Fogotcheck/TracTorKi/README.md

# **[Проект](https://github.com/Fogotcheck/TracTorKi)**

## *Клонирование репозитория*

Клонировать репозиторий вы можете следующим образом:

```console
git clone "git@github.com:Fogotcheck/TracTorKi.git"
```

## *Структура проекта*

```
├── fp-info-cache
├── fp-lib-table
├── lib
│   ├── *.kicad_sym
│   ├── *.dcm
│   ├── *.lib
│   └── *.kicad_mod
├── README.md
├── sch
│   ├── ./../*.kicad_sch
│   ├── ./../...
│   └── ./../*.kicad_sch
├── sym-lib-table
├── TracTorKi.kicad_pcb
├── TracTorKi.kicad_pro
└── TracTorKi.kicad_sch

```

## *Дополнительные ссылки*

* [Трэкер задач](https://github.com/Fogotcheck/TracTorKi/issues/new/choose)
