Fogotcheck/TracTorKi/user_temp/math.md

## Оглавление математической модели TracTorKi

1. Введение и физические параметры шасси
2. Входной вектор управления в открытом контуре
3. Дифференциальная кинематика и дискретное преобразование в ШИМ-сигналы
4. Анализ аномалий ориентации шасси на основе расстояния Махаланобиса
    * 4.1. Математическая модель генерации идеального целевого кватерниона ($q_{target}$)
    * 4.2. Перевод кватерниона ошибки в евклидово касательное пространство алгебры Ли
    * 4.3. Функция динамического масштабирования ковариационной матрицы шумов от ШИМ
    * 4.4. Критерий Хи-квадрат для фиксации аномалий
5. Сенсорная адаптация ToF-дальномеров (VL53L0X)
    * 5.1. Фильтрация Махаланобиса для ToF: Дифференциация пыли и стационарных объектов
    * 5.2. Мультипликативное обновление кватерниона IMU для подавления кубического дрейфа координат
6. Топология и геометрия обхода стационарных препятствий
    * 6.1. Математическая природа автоколебаний при детекции точечных объектов
    * 6.2. Кинематические инварианты: Тангенциальный перенос вектора через кососимметричную матрицу
    * 6.3. Топологический выбор направления обхода
    * 6.4. Финальный микс векторных полей сил
7. Справочная информация
    * 7.1. Таблица критических значений распределения Хи-квадрат ($\chi^2$)
    * 7.2. Геометрическая матрица трансформации координат для перекрёстной топологии датчиков VL53L0X
    * 7.3. Физические константы шасси (масса, база, моменты инерции, центр масс, оптический центр лазерной модели)

## 1. Введение и физические параметры шасси

[ЗАГЛУШКА / TODO: Раздел находится в разработке. Требуется внести финальные инженерные параметры физического прототипа.]

Настоящий раздел предназначен для фиксации базовых массогабаритных и конструктивных характеристик гусеничного шасси TracTorKi. Эти параметры являются фундаментальными константами для работы дифференциальной кинематики, расчета моментов инерции при внешних воздействиях и тригонометрического пересчета векторов дальномеров. 

В финальной версии документа здесь будут зафиксированы:
* Точные геометрические размеры рамы и колесной базы ($B$).
* Масса робота, координаты центра масс относительно геометрического центра.
* Тензор инерции шасси.
* Положение оптических центров лазерных дальномеров VL53L0X относительно связанной системы координат (Body-frame).

## 2. Входной вектор управления в открытом контуре

На самом верхнем уровне абстракции (уровне планирования миссий или дистанционного интерфейса) управление трактором осуществляется дискретными пакетами команд. Каждый пакет представляет собой вектор состояния $\vec{S}$, который жестко регламентирует энергетическое воздействие на движители и временной квант этого воздействия без учета обратной связи от датчиков (открытый контур):

$$\vec{S} = \begin{pmatrix} P_{left} \\ P_{right} \\ T \end{pmatrix}$$

Где компоненты вектора имеют строгое математическое и физическое описание:

*   **$P_{left} \in [-1.0; 1.0]$** — Нормированная безразмерная величина, задающая относительную целевую мощность левого борта гусеничного шасси. Знак определяет направление вращения: $>0$ — вперед, $<0$ — реверс (назад).
*   **$P_{right} \in [-1.0; 1.0]$** — Нормированная безразмерная величина, задающая относительную целевую мощность правого борта гусеничного шасси.
*   **$T \in \mathbb{N}$** — Дискретное время действия команды, выраженное в миллисекундах ($ms$). Определяет временной интервал, в течение которого контроллер обязан удерживать заданные энергетические параметры на моторах, если не зафиксировано аварийных аномалий.

Физический смысл вектора $\vec{S}$ заключается в мгновенном задании кусочно-постоянной функции распределения мощностей в связанной системе координат трактора (Body-frame). Переход к реальному изменению геометрии положения робота в пространстве происходит только после математической проекции данного вектора на уравнения кинематики шасси в следующем разделе.

## 3. Дифференциальная кинематика и дискретное преобразование в ШИМ-сигналы

Этот раздел связывает нормированные значения вектора управления $\vec{S}$ с виртуальными кинематическими параметрами движения шасси и их последующим отображением на физические регистры таймеров микроконтроллера STM32 для управления силовыми драйверами BTS7960.

### 3.1. Уравнения дифференциальной кинематики

Пусть $B$ — ширина колесной базы трактора (расстояние между продольными осями гусениц), а $V_{max}$ — экспериментально определенная максимальная линейная скорость робота при 100% заполнении ШИМ на горизонтальной поверхности. 

Нормированные мощности $P_{left}$ и $P_{right}$ линейно аппроксимируют мгновенные целевые линейные скорости левого ($V_l$) и правого ($V_r$) бортов:
$$V_l = P_{left} \cdot V_{max}$$
$$V_r = P_{right} \cdot V_{max}$$

Виртуальные кинематические параметры движения центра масс трактора в связанной системе координат (Body-frame) рассчитываются по классическим уравнениям плоского движения дифференциального шасси:

1. **Целевая линейная скорость центра масс ($V_{target}$):**
   $$V_{target} = \frac{V_r + V_l}{2} = V_{max} \cdot \frac{P_{right} + P_{left}}{2}$$

2. **Целевая угловая скорость вращения вокруг вертикальной оси Z ($\omega_{target}$):**
   $$\omega_{target} = \frac{V_r - V_l}{B} = \frac{V_{max}}{B} \cdot (P_{right} - P_{left})$$

### 3.2. Дискретное ШИМ-преобразование для драйверов BTS7960

Каждый борт шасси управляется независимым полумостовым драйвером BTS7960, который требует раздельной подачи ШИМ-сигналов на каналы прямого движения (Forward) и реверса (Backward) для исключения сквозных токов.

Пусть $ARR$ (Auto-Reload Register) — максимальное значение периода цифрового таймера STM32, определяющее аппаратную разрядность ШИМ (например, $ARR = 65535$ для 16-битного таймера). 

Математическая функция отображения нормированной мощности $P \in [-1.0; 1.0]$ в дискретные значения регистров сравнения таймера $CCR_{Forward}$ и $CCR_{Backward}$ является кусочно-линейной и имеет вид:

*   **Для левого борта ($P_{left}$):**
    $$CCR_{L\_Forward} = \begin{cases} \lfloor |P_{left}| \cdot ARR \rfloor, & P_{left} \ge 0 \\ 0, & P_{left} < 0 \end{cases}$$
    $$CCR_{L\_Backward} = \begin{cases} 0, & P_{left} \ge 0 \\ \lfloor |P_{left}| \cdot ARR \rfloor, & P_{left} < 0 \end{cases}$$

*   **Для правого борта ($P_{right}$):**
    $$CCR_{R\_Forward} = \begin{cases} \lfloor |P_{right}| \cdot ARR \rfloor, & P_{right} \ge 0 \\ 0, & P_{right} < 0 \end{cases}$$
    $$CCR_{R\_Backward} = \begin{cases} 0, & P_{right} \ge 0 \\ \lfloor |P_{right}| \cdot ARR \rfloor, & P_{right} < 0 \end{cases}$$

Данное преобразование выполняется аппаратно-зависимым слоем абстракции (HAL) микроконтроллера на каждом шаге итерации основного таймера управления.

## 4. Анализ аномалий ориентации шасси на основе расстояния Махаланобиса

### 4.1. Математическая модель генерации идеального целевого кватерниона ($q_{target}$)

Для фиксации внешних механических возмущений (например, воздействие кота или ребенка) бортовой вычислитель должен непрерывно рассчитывать эталонное угловое положение, которое трактор имел бы в идеальных условиях при отсутствии проскальзывания гусениц и внешних сил.

Пусть текущая пространственная ориентация шасси в глобальной системе координат (World-frame) описывается нормированным целевым кватернионом:

$$q_{target}(t) = \begin{pmatrix} w_{tg} \\ x_{tg} \\ y_{tg} \\ z_{tg} \end{pmatrix}, \quad ||q_{target}|| = 1$$

На каждом дискретном такте управления $\Delta t$ (период интеграции одометрии) из кинематических уравнений раздела 3 извлекается вектор целевой угловой скорости движения в связанной системе координат (Body-frame). Так как плоское дифференциальное шасси способно вращаться только вокруг собственной вертикальной оси $Z$, трехмерный вектор угловой скорости $\vec{\omega}_{body}$ имеет вид:

$$\vec{\omega}_{body} = \begin{pmatrix} 0 \\ 0 \\ \omega_{target} \end{pmatrix} = \begin{pmatrix} 0 \\ 0 \\ \frac{V_{max}}{B} \cdot (P_{right} - P_{left}) \end{pmatrix}$$

Изменение ориентации за малый промежуток времени $\Delta t$ описывается кватернионом малого поворота $\Delta q_{tg}$, вычисляемым через экспоненциальное отображение угловой скорости (в приближении малых углов):

$$\Delta q_{tg} \approx \begin{pmatrix} \cos\left(\frac{\omega_{target} \cdot \Delta t}{2}\right) \\ 0 \\ 0 \\ \sin\left(\frac{\omega_{target} \cdot \Delta t}{2}\right) \end{pmatrix}$$

Математическая модель эволюции идеального состояния реализуется путем правого мультипликативного обновления текущего целевого кватерниона на кватернион малого приращения:

$$q_{target}(t + \Delta t) = q_{target}(t) \otimes \Delta q_{tg}$$

Где оператор $\otimes$ выполняет классическое кватернионное умножение Грассмана:

$$q_{target}(t + \Delta t) = \begin{pmatrix} 
w_{tg} \cdot \cos\left(\frac{\omega_{target} \cdot \Delta t}{2}\right) - z_{tg} \cdot \sin\left(\frac{\omega_{target} \cdot \Delta t}{2}\right) \\
x_{tg} \cdot \cos\left(\frac{\omega_{target} \cdot \Delta t}{2}\right) + y_{tg} \cdot \sin\left(\frac{\omega_{target} \cdot \Delta t}{2}\right) \\
y_{tg} \cdot \cos\left(\frac{\omega_{target} \cdot \Delta t}{2}\right) - x_{tg} \cdot \sin\left(\frac{\omega_{target} \cdot \Delta t}{2}\right) \\
z_{tg} \cdot \cos\left(\frac{\omega_{target} \cdot \Delta t}{2}\right) + w_{tg} \cdot \sin\left(\frac{\omega_{target} \cdot \Delta t}{2}\right)
\end{pmatrix}$$

После выполнения операции умножения во избежание накопления вычислительных погрешностей округления микроконтроллер производит принудительную ренормализацию вектора состояния:

$$q_{target} \leftarrow \frac{q_{target}}{||q_{target}||}$$

Полученный кватернион $q_{target}$ выступает в качестве динамического математического эталона для сравнения с физическими показаниями датчика BNO085 на следующем шаге.

### 4.2. Перевод кватерниона ошибки в евклидово касательное пространство алгебры Ли

Для сравнения идеального математического эталона $q_{target}$ с реальным пространственным положением трактора $q_{real}$, транслируемым датчиком BNO085, невозможно использовать классическое евклидово вычитание элементов. Кватернионы лежат на трехмерной гиперсфере $S^3$ в четырехмерном пространстве $\mathbb{R}^4$, и их прямая разность нарушает свойство унитарности ($||q||=1$).

Взаимосвязь между реальной и целевой ориентациями описывается мультипликативным кватернионом ошибки $\Delta q$, который определяет операцию поворота, необходимую для совмещения реального шасси с его идеальной моделью:

$$q_{target} = q_{real} \otimes \Delta q \implies \Delta q = q_{real}^{-1} \otimes q_{target}$$

Операция инверсии для нормированного кватерниона эквивалентна его комплексному сопряжению: $q_{real}^{-1} = \begin{pmatrix} w_{rl} & -x_{rl} & -y_{rl} & -z_{rl} \end{pmatrix}^T$. Результат умножения Грассмана формирует четырехмерный вектор ошибки:

$$\Delta q = \begin{pmatrix} \Delta w \\ \Delta x \\ \Delta y \\ \Delta z \end{pmatrix} = \begin{pmatrix}
w_{rl} \cdot w_{tg} + x_{rl} \cdot x_{tg} + y_{rl} \cdot y_{tg} + z_{rl} \cdot z_{tg} \\
w_{rl} \cdot x_{tg} - x_{rl} \cdot w_{tg} - y_{rl} \cdot z_{tg} + z_{rl} \cdot y_{tg} \\
w_{rl} \cdot y_{tg} + x_{rl} \cdot z_{tg} - y_{rl} \cdot w_{tg} - z_{rl} \cdot x_{tg} \\
w_{rl} \cdot z_{tg} - x_{rl} \cdot y_{tg} + y_{rl} \cdot x_{tg} - z_{rl} \cdot w_{tg}
\end{pmatrix}$$

Для корректного линейного анализа аномалий трехмерный вектор расхождения проецируется из нелинейной группы Ли $SU(2)$ в линейное касательное евклидово пространство алгебры Ли $\mathfrak{so}(3)$ с помощью логарифмического отображения $\operatorname{log}(\Delta q)$. Полученный вектор ошибки $\vec{e}$ выражает физические углы расхождения (в радианах) вокруг трех связанных осей трактора ($X$ — крен, $Y$ — тангаж, $Z$ — рыскание):

$$\vec{e} = \begin{pmatrix} e_x \\ e_y \\ e_z \end{pmatrix} = \operatorname{log}(\Delta q) = \frac{2 \cdot \operatorname{acos}(\Delta w)}{\sqrt{1 - \Delta w^2}} \cdot \begin{pmatrix} \Delta x \\ \Delta y \\ \Delta z \end{pmatrix}$$

Во избежание сингулярности деления на ноль при идеальном совпадении траекторий ($\Delta w \to 1$, $\alpha \to 0$), применяется разложение в ряд Тейлора первого порядка в окрестности нуля. При условии $\sqrt{1 - \Delta w^2} < 10^{-4}$ математический расчет переходит к линейному приближению:

$$\vec{e} \approx 2 \cdot \begin{pmatrix} \Delta x \\ \Delta y \\ \Delta z \end{pmatrix}$$

Вектор $\vec{e}$ представляет собой чистую евклидову метрику расхождения ориентаций, инвариантную к текущему направлению движения робота, и готов к ковариационному анализу.

### 4.3. Функция динамического масштабирования ковариационной матрицы шумов от ШИМ

В процессе движения гусеничное шасси TracTorKi генерирует переменный уровень механических вибраций, зависящий от текущих оборотов двигателей и характера взаимодействия движителей с подстилающей поверхностью. В статической позиции шум измерений инерциального датчика BNO085 минимален, однако при подаче напряжения на моторы дисперсия ошибок угловой ориентации возрастает. 

Чтобы математическая модель не генерировала ложные сигналы об аномалиях при штатном разгоне, ковариационная матрица шумов $\Sigma_t$ должна динамически адаптироваться под текущую нагрузку.

Пусть вектор ошибок $\vec{e} = \begin{pmatrix} e_x & e_y & e_z \end{pmatrix}^T$ распределен по нормальному закону с нулевым математическим ожиданием. Поскольку оси крена ($X$) и тангажа ($Y$) мало подвержены влиянию дифференциального руления, а основная вибрационная нагрузка и проскальзывание приходятся на ось рыскания ($Z$), динамическая ковариационная матрица $\Sigma_t$ имеет диагональный вид:

$$\Sigma_t = \begin{pmatrix} \sigma_{x}^2 & 0 & 0 \\ 0 & \sigma_{y}^2 & 0 \\ 0 & 0 & \sigma_z^2(t) \end{pmatrix}$$

Где компоненты матрицы рассчитываются следующим образом:

1. **Базовый шум осей крена и тангажа:**
   $$\sigma_{x}^2 = \sigma_{static\_x}^2$$
   $$\sigma_{y}^2 = \sigma_{static\_y}^2$$
   *(Значения $\sigma_{static\_x}^2$ и $\sigma_{static\_y}^2$ являются константами, определяемыми в ходе калибровки неподвижного шасси).*

2. **Динамическая дисперсия оси рыскания ($\sigma_z^2(t)$):**
   Функция масштабирования шума зависит от среднего модуля нормированной мощности левого и правого бортов, поступающей из открытого контура (Раздел 2):

   $$\sigma_z^2(t) = \sigma_{static\_z}^2 + K_{vib} \cdot \left( \frac{|P_{left}| + |P_{right}|}{2} \right)^2$$

   Где:
   *   $\sigma_{static\_z}^2$ — дисперсия шума датчика по оси $Z$ в состоянии покоя ($rad^2$).
   *   $K_{vib}$ — безразмерный эмпирический коэффициент структурной вибрации шасси, определяемый экспериментально при движении робота с максимальной мощностью по жесткому грунту.

Благодаря квадратичной зависимости от средней мощности, матрица $\Sigma_t$ мгновенно «раздувает» доверительный интервал в моменты интенсивного ускорения или разворота на месте, повышая устойчивость фильтра к внутренним шумам системы.

### 4.4. Критерий Хи-квадрат для фиксации аномалий

Имея линеаризованный вектор угловых ошибок $\vec{e}$ (Пункт 4.2) и динамическую ковариационную матрицу шумов $\Sigma_t$ (Пункт 4.3), бортовой вычислитель рассчитывает расстояние Махаланобиса $D_M$. Эта метрика определяет многомерное взвешенное расстояние между теоретическим состоянием шасси и реальными показаниями IMU-датчика с учетом переменной интенсивности вибраций:

$$D_M = \sqrt{\vec{e}^T \cdot \Sigma_t^{-1} \cdot \vec{e}}$$

Учитывая диагональную структуру матрицы $\Sigma_t$, операция обращения матрицы $\Sigma_t^{-1}$ сводится к вычислению обратных величин её диагональных элементов. Это позволяет упростить квадратичную форму до эффективного скалярного уравнения:

$$D_M = \sqrt{\frac{e_x^2}{\sigma_{x}^2} + \frac{e_y^2}{\sigma_{y}^2} + \frac{e_z^2}{\sigma_z^2(t)}}$$

Математически квадрат расстояния Махаланобиса $D_M^2$ для трехмерного вектора ошибок ($k = 3$ степеней свободы) подчиняется распределению Хи-квадрат ($\chi^2$). Для фиксации аномалий применяется статистический критерий согласия Пирсона с заданным уровнем значимости $\alpha = 0.01$ (вероятность ложноположительного срабатывания менее 1%):

$$D_M^2 > \chi^2_{1-\alpha}(3)$$

Согласно таблице критических значений распределения Хи-квадрат для 3 степеней свободы (Раздел 7.1), пороговое значение составляет $\chi^2_{0.99}(3) = 11.345$, что эквивалентно линейному порогу расстояния Махаланобиса $D_{thresh} \approx 3.368$. 

Логика принятия решений классифицирует состояние системы по следующим математическим интервалам:
*   **$D_M \le 2.21$** — Номинальный режим: расхождение вызвано естественным белым шумом датчика, система стабильна.
*   **$2.21 < D_M \le 3.37$** — Пограничный режим: повышенный уровень скольжения гусениц или движение по сильно пересеченной местности, система корректирует траекторию в штатном режиме.
*   **$D_M > 3.37$** — **Внешняя механическая аномалия**: гипотеза о соответствии реального движения математической модели отвергается. Контроллер фиксирует факт стороннего физического сдвига шасси (толчок ребенком, воздействие кота), прерывает таймер открытого контура $T$ и переходит к процедуре экстренной релокализации.

## 5. Сенсорная адаптация ToF-дальномеров (VL53L0X)

### 5.1. Фильтрация Махаланобиса для ToF: Буферизация и дифференциация стационарных объектов

Лазерные дальномеры ToF (Time-of-Flight) подвержены кратковременным оптическим шумам, фазовому дрожанию (jitter) и резким помехам (пыль, шерсть). Прямое вычисление скорости изменения дистанции по двум последовательным отсчётам приводит к катастрофическому усилению высокочастотного шума. Для корректного принятия решений модель использует накопление измерений в скользящем временном окне (буфере) фиксированной длительности $\tau \approx 200\text{--}500$ мс.

Для каждого лазерного дальномера $i \in \{1, 2, 3, 4\}$ бортовой вычислитель поддерживает кольцевой буфер из $N$ последних отсчётов, полученных с постоянным периодом дискретизации $\Delta t$:

$$\mathcal{B}_i = \{D_i(t), D_i(t-\Delta t), D_i(t-2\Delta t), \dots, D_i(t-(N-1)\Delta t)\}$$

На основе накопленного буфера $\mathcal{B}_i$ вектор состояния ToF-луча $\vec{x}_{tof, i}$ формируется не через мгновенные разности, а через робастную оценку тренда методом линейной регрессии (наименьших квадратов) внутри временного окна:

$$\vec{x}_{tof, i} = \begin{pmatrix} \bar{D}_i(t) \\ \dot{D}_{i, \text{est}}(t) \end{pmatrix}$$

Где:
*   $\bar{D}_i(t)$ — усредненное (сглаженное) текущее расстояние, вычисленное по буферу.
*   $\dot{D}_{i, \text{est}}(t)$ — наклонение линии тренда (оценка скорости изменения дистанции), минимизирующее среднеквадратичное отклонение в буфере:

$$\dot{D}_{i, \text{est}}(t) = \frac{N \sum_{k=0}^{N-1} (t_k \cdot D_i(t_k)) - \sum_{k=0}^{N-1} t_k \sum_{k=0}^{N-1} D_i(t_k)}{N \sum_{k=0}^{N-1} t_k^2 - \left(\sum_{k=0}^{N-1} t_k\right)^2}$$

Математическое ожидание (прогноз) вектора измерений строится на базе предыдущего стабильного состояния и физической скорости трактора $V_{target}$ из Раздела 3, спроецированной на ось $i$-го луча с углом наклона $\gamma_i$:

$$\vec{\mu}_{tof, i} = \begin{pmatrix} \bar{D}_i(t-\Delta t) - V_{target} \cdot \cos(\gamma_i) \cdot \Delta t \\ -V_{target} \cdot \cos(\gamma_i) \end{pmatrix}$$

Ковариационная матрица $\Sigma_{tof}$ в данном случае рассчитывается динамически на основе выборочной дисперсии шума внутри самого накопленного буфера $\mathcal{B}_i$, что позволяет учитывать текущую оптическую стабильность среды (например, запыленность):

$$\Sigma_{tof} = \begin{pmatrix} \sigma^2_{buf, i} & 0 \\ 0 & \frac{\sigma^2_{buf, i}}{\tau} \end{pmatrix}$$

Где $\sigma^2_{buf, i}$ — несмещенная дисперсия расстояния по $N$ элементам буфера.

Расчет расстояния Махаланобиса выполняется по сглаженным метрикам:

$$D_{M\_tof, i} = \sqrt{(\vec{x}_{tof, i} - \vec{\mu}_{tof, i})^T \cdot \Sigma_{tof}^{-1} \cdot (\vec{x}_{tof, i} - \vec{\mu}_{tof, i})}$$

Статистический критерий Хи-квадрат для 2 степеней свободы ($\chi^2_{0.99}(2) = 9.21$) делит входящий поток данных на два класса:
1.  **$D_{M\_tof, i} \le 3.03$ (Стационарный объект):** Линейный тренд буфера полностью совпадает с кинематикой трактора. Препятствие признается неподвижным и стабильным ориентиром окружения (стена, шкаф, крупная мебель). Данные $\bar{D}_i(t)$ признаются валидными и передаются в алгоритм мультипликативной коррекции кватерниона IMU (Пункт 5.2) для сброса дрейфа.
2.  **$D_{M\_tof, i} > 3.03$ (Аномалия измерения):** Вектор тренда и дисперсия буфера не соответствуют предсказанной кинематике движения шасси. Объект классифицируется как динамическая или оптическая помеха (пролетевшая пыль, прыгнувший кот, взмах руки, занос гусеницы). 
    *   **Действие системы:** Модель временно **запрещает** использовать данный ToF-луч для корректировки навигационного контура IMU во избежание внесения ложных смещений. Трактор продолжает штатное выполнение текущего полетного задания открытого контура, временно накапливая внутреннюю ошибку инерциальной одометрии до момента стабилизации показаний дальномера. Никаких команд принудительного торможения или изменения ШИМ-сигналов на моторы в данном подпункте не генерируется.

### 5.2. Мультипликативное обновление кватерниона IMU для подавления кубического дрейфа координат

Инерциальная система навигации на базе датчика BNO085 обладает высокой дискретностью, но подвержена накоплению систематических погрешностей. Ошибки интегрирования угловых скоростей вызывают линейный дрейф углов ориентации, а двойное интегрирование линейных ускорений приводит к кубическому росту ошибки определения координат по времени ($t^3$). 

Чтобы разорвать эту зависимость, математическая модель использует верифицированные стационарные измерения дальномеров VL53L0X ($D_{M\_tof, i} \le 3.03$) для фильтрации и периодической коррекции вектора состояния.

Пусть $q_{pred}$ — текущий кватернион ориентации, предсказанный инерциальной системой, а $D_{real, i} = \bar{D}_i(t)$ — чистое расстояние от $i$-го датчика, прошедшее фильтр Махаланобиса. Известная геометрическая конфигурация лучей (Раздел 7.2) позволяет рассчитать ожидаемое расстояние до стационарного ориентира $D_{pred, i}$. 

Математический шаг обновления (Correction) строится на принципах мультипликативного фильтра Калмана (MEKF):

1. **Вычисление скалярной инновации (невязки измерения):**
   $$y_i = D_{real, i} - D_{pred, i}$$

2. **Расчет вектора поправки в касательном пространстве:**
   Через оптимальный коэффициент обратной связи $K_i$ (вес Калмана, определяемый соотношением дисперсий предсказания IMU и измерения ToF) инновация отображается в трехмерный вектор малых угловых ошибок $\vec{\delta\theta}$:
   $$\vec{\delta\theta} = \begin{pmatrix} \delta\theta_x \\ \delta\theta_y \\ \delta\theta_z \end{pmatrix} = K_i \cdot y_i \cdot \vec{u}_i$$
   Где $\vec{u}_i$ — единичный вектор направления $i$-го лазерного луча в связанной системе координат трактора.

3. **Формирование корректирующего кватерниона малого поворота ($\delta q$):**
   Вектор малой ошибки преобразуется обратно в пространство кватернионов через ортогональную проекцию на гиперсферу:
   $$\delta q \approx \begin{pmatrix} 1 \\ \frac{\delta\theta_x}{2} \\ \frac{\delta\theta_y}{2} \\ \frac{\delta\theta_z}{2} \end{pmatrix}$$

4. **Мультипликативный пересчет матрицы ориентации:**
   Коррекция вносится путем правого кватернионного умножения Грассмана, что исключает появление линейных сингулярностей, характерных для углов Эйлера:
   $$q_{corrected} = q_{pred} \otimes \delta q$$

5. **Ренормализация и сброс дрейфа одометрии:**
   После внесения поправки вектор состояния принудительно возвращается на единичную гиперсферу, а накопленная кубическая ошибка скорости по оси скорректированного луча обнуляется:
   $$q_{corrected} \leftarrow \frac{q_{corrected}}{||q_{corrected}||}$$

Этот шаг математически «привязывает» координатную сетку трактора к стационарным физическим объектам среды, полностью останавливая временной дрейф интеграторов IMU по тем осям, которые перекрываются геометрией датчиков.

## 6. Топология и геометрия обхода стационарных препятствий

### 6.1. Математическая природа автоколебаний при детекции точечных объектов

Тонкие вертикальные препятствия, такие как ножки стульев, столов или малогабаритные игрушки, математически интерпретируются дальномерами как точечные объекты (цилиндры исчезающе малого радиуса $r \to 0$). Специфика лазерных ToF-датчиков VL53L0X заключается в чрезвычайно узкой диаграмме направленности излучения (конус излучения FoV составляет порядка $25^\circ$, а центральное пятно измерения еще уже). Из-за этой особенности возникает фундаментальная топологическая ловушка при попытке реализации классического пропорционального отталкивания.

Рассмотрим систему, в которой вектор силы отталкивания $\vec{F}_{rep}$ направлен строго коллинеарно лучу датчика — от обнаруженной точечной аномалии к геометрическому центру трактора. Физико-математический механизм возникновения незатухающих автоколебаний (релаксационного осцилляционного процесса) протекает по следующим фазам:

1. **Фаза детекции и отклонения:** Трактор движется вперед; один из перекрестных лучей (например, лучи №3 или №4 согласно схеме из Раздела 7.2) пересекает ножку стула на критической дистанции $D_{real} < R_{safe}$. Махаланобис валидирует стационарность объекта. Модель генерирует вектор отталкивания $\vec{F}_{rep}$, модуль которого обратно пропорционален расстоянию. Под действием этой силы трактор начинает динамически разворачивать шасси в противоположную от объекта сторону.

2. **Фаза срыва слежения:** Как только угловое смещение трактора превышает половину угла FoV датчика, точечный объект мгновенно «выпадает» из узкого лазерного луча. В эту же миллисекунду расстояние до объекта прыгает до бесконечности (или до дальней стены), и вектор силы отталкивания мгновенно обнуляется:
   $$\vec{F}_{rep} \to \vec{0}$$

3. **Фаза возврата и столкновения:** Поскольку целевой вектор открытого контура $\vec{F}_{att}$ (Раздел 2) продолжает требовать движения вперед к исходной цели, трактор прекращает маневр уклонения и начинает выравнивать курс обратно. Траектория робота снова пересекается с координатой ножки стула.

4. **Замыкание цикла:** Луч дальномера повторно натыкается на точечное препятствие, вызывая резкий скачок силы $\vec{F}_{rep}$. 

Математически данный процесс описывается нелинейным дифференциальным уравнением второго порядка с релейной функцией обратной связи и запаздыванием. На фазовой плоскости траектория системы замыкается в устойчивый предельный цикл (Limit Cycle). В физическом мире это выражается в том, что трактор начинает циклически «дёргаться» и совершать высокочастотные колебания (эффект рыскания) непосредственно перед ножкой стула, теряя линейную скорость и в конечном итоге совершая механическое столкновение с препятствием из-за инерции шасси.

### 6.2. Кинематические инварианты: Тангенциальный перенос вектора через кососимметричную матрицу

Чтобы полностью исключить разрыв обратной связи и разрушить предельный цикл автоколебаний, математическая модель переводит трактор из режима фронтального отталкивания в режим орбитального огибания. Для этого вокруг обнаруженной точечной координаты аномалии $(X_{obs}, Y_{obs})$ в связанной системе координат (Body-frame) искусственно выстраивается инвариантная круговая граница — сфера безопасности радиуса $R_{safe}$.

Математический маневр уклонения требует, чтобы результирующий вектор движения был направлен не в сторону от объекта, а строго по касательной к окружности радиуса $R_{safe}$. Преобразование радиальной силы в тангенциальную траекторию реализуется через аппарат линейной алгебры с применением двумерной кососимметричной матрицы поворота.

Пусть $\vec{F}_{rep} = \begin{pmatrix} F_{rep\_x} & F_{rep\_y} \end{pmatrix}^T$ — исходный вектор радиального выталкивания, направленный от точечного препятствия к центру масс трактора. Мы осуществляем ортогональное проецирование этого вектора в касательное пространство путем умножения на кососимметричную матрицу оператора поворота на угол $\pm\pi/2$:

$$\vec{F}_{tangent} = \mathbf{J} \cdot \vec{F}_{rep}$$

Где матрица поворота $\mathbf{J}$ имеет вид:

$$\mathbf{J} = \begin{pmatrix} 0 & -\Lambda \\ \Lambda & 0 \end{pmatrix}$$

Параметр $\Lambda \in \{-1; 1\}$ является топологическим инвариантом знака и жестко определяет бинарный выбор направления обхода препятствия:
*   $\Lambda = 1$ — Поворот вектора на $+90^\circ$ (математически против часовой стрелки).
*   $\Lambda = -1$ — Поворот вектора на $-90^\circ$ (математически по часовой стрелке).

Разворачивая матричное уравнение в систему скалярных кинематических инвариантов, получаем точные компоненты тангенциального вектора переноса:

$$F_{tangent\_x} = -\Lambda \cdot F_{rep\_y}$$
$$F_{tangent\_y} = \Lambda \cdot F_{rep\_x}$$

Полученный вектор $\vec{F}_{tangent}$ обладает свойством строгой ортогональности к радиальному вектору ($\vec{F}_{tangent} \cdot \vec{F}_{rep} = 0$). Физический смысл этой операции заключается в том, что вместо хаотичного отворачивания назад, модель генерирует постоянную виртуальную «орбитальную скорость». Трактор начинает двигаться по гладкой дуге вокруг ножки стула, удерживая её под постоянным фиксированным углом к лучам лазерных дальномеров (VL53L0X). Это гарантирует непрерывность слежения за препятствием и полностью подавляет любые триггерные осцилляции.

### 6.3. Топологический выбор направления обхода

Для однозначного раскрытия неопределенности знака инварианта $\Lambda \in \{-1; 1\}$ в подразделе 6.2 бортовой вычислитель должен в реальном времени решать топологическую задачу оптимизации маршрута. Выбор направления огибания (слева или справа) основывается на минимизации энергетических затрат и интегрального отклонения от исходного курса открытого контура.

#### 6.3.1. Скалярный критерий знака для одиночного препятствия
Пусть $\vec{F}_{att} = \begin{pmatrix} F_{att\_x} & F_{att\_y} \end{pmatrix}^T$ — притягивающий вектор глобальной цели, а $\vec{F}_{tangent}(\Lambda)$ — тангенциальный вектор обхода, зависящий от знака $\Lambda$. Математическим критерием оптимальности является максимизация скалярного произведения этих векторов, что соответствует минимизации угла расхождения между направлением обхода и направлением на цель:

$$\Lambda^* = \arg\max_{\Lambda \in \{-1, 1\}} \left( \vec{F}_{tangent}(\Lambda) \cdot \vec{F}_{att} \right)$$

Разворачивая скалярное произведение через компоненты векторов, получаем явную аналитическую функцию знака (signum), не требующую тригонометрических вычислений на процессоре STM32:

$$\Lambda^* = \operatorname{sgn} \left( F_{rep\_x} \cdot F_{att\_y} - F_{rep\_y} \cdot F_{att\_x} \right)$$

Если результирующее выражение строго больше нуля, присваивается $\Lambda = 1$ (обход слева), если меньше — $\Lambda = -1$ (обход справа). В редком случае строгого равенства нулю (коллинеарный лобовой упор) знак выбирается аппаратно на основе приоритета датчиков схемы из Раздела 7.2 (например, в сторону датчика с наименьшим текущим значением шума).

#### 6.3.2. Суперпозиция полей при множественных целях (Проблема «Узких ворот»)
Когда в зону безопасности $R_{safe}$ одновременно попадают несколько стационарных аномалий (например, две смежные ножки стула или стола), система строит аддитивное топологическое поле. Для $M$ одновременно обнаруженных объектов суммарный вектор отталкивания и результирующий знак обхода рассчитываются через весовую суперпозицию:

$$\vec{F}_{rep\_sum} = \sum_{j=1}^{M} w_j \cdot \vec{F}_{rep, j}$$

Где вес $w_j = \left(\frac{1}{D_j} - \frac{1}{R_{safe}}\right)$ увеличивает приоритет наиболее близких к шасси препятствий. 

В ситуации, когда два объекта находятся по разные стороны от продольной оси трактора (слева и справа), их радиальные силы взаимно компенсируют друг друга в проекции на ось $Y$, смещая суммарный вектор $\vec{F}_{rep\_sum}$ строго на ось $X$ (торможение). Топологический инвариант знака $\Lambda^*$ для объединенного поля автоматически рассчитывается через результирующий вектор:

$$\Lambda^* = \operatorname{sgn} \left( F_{rep\_sum\_x} \cdot F_{att\_y} - F_{rep\_sum\_y} \cdot F_{att\_x} \right)$$

Если расстояние между двумя ножками меньше физической ширины базы шасси $B$, модули векторов отталкивания резко возрастают, полностью блокируя продвижение вперед по оси $X$ через механизмы Пункта 6.4. Система топологически распознает тупик («узкие ворота»), принудительно разворачивает вектор $\vec{F}_{att}$ в обратную сторону и инициирует маневр безопасного отката по касательной дуге до момента раскрытия створа препятствий.

### 6.4. Финальный микс векторных полей сил

На заключительном этапе навигационного цикла бортовой вычислитель выполняет суперпозицию всех сформированных векторных полей для вычисления результирующего вектора управления $\vec{F}_{result}$. Этот вектор осуществляет плавную подмену исходных жестких команд открытого контура, обеспечивая безопасное огибание препятствий без разрыва траектории.

Математическое сложение трех независимых полей сил в связанной системе координат (Body-frame) имеет вид:

$$\vec{F}_{result} = \vec{F}_{att} + \vec{F}_{rep\_sum} + \vec{F}_{tangent}$$

Где физическая роль каждого слагаемого строго регламентирована:
1.  **$\vec{F}_{att}$** — Сила глобального притяжения к цели, сонаправленная с исходным вектором управления $\vec{S}$. Она удерживает трактор на основном маршруте.
2.  **$\vec{F}_{rep\_sum}$** — Суммарная радиальная сила выталкивания (Пункт 6.3.2). Она гарантирует физическое непересечение установленной сферы безопасности $R_{safe}$.
3.  **$\vec{F}_{tangent}$** — Тангенциальная сила обхода (Пункт 6.2). Она задает орбитальный перенос вдоль границы препятствия.

Из полученного вектора $\vec{F}_{result} = \begin{pmatrix} F_{res\_x} & F_{res\_y} \end{pmatrix}^T$ извлекается скорректированный целевой угол направления движения $\alpha_{res}$ относительно продольной оси трактора:

$$\alpha_{res} = \operatorname{atan2}(F_{res\_y}, F_{res\_x})$$

Финальный пересчет нормированных мощностей для левого ($P_{left\_new}$) и правого ($P_{right\_new}$) бортов гусеничного шасси выполняется по закону пропорционального регулирования угла курса:

$$P_{left\_new} = F_{res\_x} - K_p \cdot \alpha_{res}$$
$$P_{right\_new} = F_{res\_x} + K_p \cdot \alpha_{res}$$

Где $K_p$ — коэффициент жесткости руления, определяющий динамику закручивания шасси в маневр. Для предотвращения аппаратного насыщения ШИМ-таймеров полученные значения мощностей проходят операцию жесткого ограничения (насыщения) в исходный рабочий диапазон Раздела 2:

$$P_{left\_new} \leftarrow \max(-1.0, \min(1.0, P_{left\_new}))$$
$$P_{right\_new} \leftarrow \max(-1.0, \min(1.0, P_{right\_new}))$$

Скорректированные нормированные мощности $P_{left\_new}$ и $P_{right\_new}$ напрямую передаются на слой преобразования в ШИМ-сигналы (Раздел 3), замыкая контур автоматического адаптивного управления платформой.

## 7. Справочная информация и аналитические инварианты

### 7.1. Таблица критических значений распределения Хи-квадрат ($\chi^2$)
Для детекции аномалий ориентации шасси (Раздел 4.4) и валидации ToF-измерений дальномеров (Раздел 5.1) в памяти микроконтроллера STM32 фиксируются константные пороговые значения распределения Хи-квадрат ($\chi^2$). Ниже представлена таблица критических значений $\chi^2_{1-\alpha}(k)$ в зависимости от числа степеней свободы $k$ и заданного уровня значимости $\alpha$:

| Число степеней свободы ($k$) | $\alpha = 0.10$ (10%) | $\alpha = 0.05$ (5%) | $\alpha = 0.01$ (1%) | Применение в системе TracTorKi |
| :--- | :--- | :--- | :--- | :--- |
| **1** | 2.706 | 3.841 | 6.635 | Одномерные скалярные фильтры |
| **2** | 4.605 | 5.991 | **9.210** | Валидация ToF-лучей (дистанция и скорость) |
| **3** | 6.251 | 7.815 | **11.345**| Анализ аномалий кватерниона IMU (3 оси алгебры Ли) |

Математический переход от порогового квадрата расстояния Махаланобиса $D_M^2 > \chi^2_{1-\alpha}(k)$ к линейному порогу $D_{thresh}$ осуществляется через извлечение квадратного корня:
*   Для ToF-датчиков ($k=2$, $\alpha=0.01$): $D_{thresh} = \sqrt{9.210} \approx 3.035$
*   Для кватерниона IMU ($k=3$, $\alpha=0.01$): $D_{thresh} = \sqrt{11.345} \approx 3.368$

### 7.2. Динамическая идентификация центра масс на основе инерциальной фильтрации (IMU-based CoG Estimation)

Для исключения погрешностей априорного взвешивания компонентов, модель производит динамическую оценку вектора положения центра масс $\vec{r}_{cg}$ непосредственно на основе кинематических корреляций датчика BNO085 в процессе калибровочного маневра.

Пусть связанная система координат (Body-frame) жестко привязана к точке оптического/геометрического центра инерциального датчика IMU. Вектор смещения реального центра масс шасси относительно датчика обозначается как $\vec{r}_{c} = \begin{pmatrix} X_c & Y_c & Z_c \end{pmatrix}^T$. 

Связь между измеряемым акселерометром ускорением в точке крепления $\vec{a}_{imu}$ и истинным ускорением центра масс $\vec{a}_{cg}$ описывается кинематическим уравнением твердого тела:

$$\vec{a}_{imu} = \vec{a}_{cg} + \vec{\varepsilon} \times \vec{r}_{c} + \vec{\omega} \times (\vec{\omega} \times \vec{r}_{c})$$

При выполнении тестового вращения шасси на месте (разворот в открытом контуре с противоположными знаками мощностей $P_{left} = -P_{right}$), истинное линейное ускорение центра масс стремится к нулю ($\vec{a}_{cg} \to \vec{0}$). Проекция уравнений на плоскость движения $XY$ формирует систему для идентификации горизонтального смещения:

$$a_x(t) = \varepsilon_z(t) \cdot Y_c - \omega_z^2(t) \cdot X_c$$
$$a_y(t) = -\varepsilon_z(t) \cdot X_c - \omega_z^2(t) \cdot Y_c$$

Где $a_x, a_y, \omega_z$ — прямые высокодискретные измерения датчика BNO085, а $\varepsilon_z = \frac{\Delta \omega_z}{\Delta t}$ — вычисляемое угловое ускорение. Бортовой вычислитель STM32 методом наименьших квадратов (МНК) по накопленному буферу калибровочного маневра разрешает данную систему относительно инвариантов геометрии:

$$\begin{pmatrix} X_c \\ Y_c \end{pmatrix} = \left( \mathbf{A}^T \mathbf{A} \right)^{-1} \mathbf{A}^T \vec{\mathbf{Y}}$$

Где матрица измерений $\mathbf{A}$ и вектор ограничений $\vec{\mathbf{Y}}$ строятся динамически на скользящем окне калибровки. Вертикальная координата высоты центра масс $Z_c$ оценивается во второй фазе теста при линейном ускорении по оси $X$ через величину динамического завала угла тангажа (Pitch), регистрируемого кватернионом IMU под действием сил опрокидывания. Динамически вычисленный вектор $\vec{r}_{c}$ используется для мгновенной корректировки плеча сил инерции в критериях аварийной остановки платформы (Раздел 7.4).

### 7.3. Геометрия перекрёстной топологии и аналитическая модель автоматической калибровки оптических углов датчиков VL53L0X

Вместо использования априорных чертежных значений углов установки, система реализует алгоритм автоматической геометрической самокалибровки ToF-лучей (Auto-Calibration via Planar Target) при совершении тестовых перемещений относительно плоской стационарной поверхности (стены).

Пусть связанная система координат (Body-frame) привязана к динамическому центру масс шасси (Раздел 7.2). Каждый датчик $i \in \{1, 2, 3, 4\}$ характеризуется точкой пространственного размещения своего оптического центра $\vec{r}_{sns, i} = \begin{pmatrix} x_i & y_i \end{pmatrix}^T$ и вектором направления луча $\vec{u}_i = \begin{pmatrix} \cos(\gamma_i) & \sin(\gamma_i) \end{pmatrix}^T$.

#### 7.3.1. Аналитическая идентификация углов лучей ($\gamma_i$)
При совершении калибровочного маневра (линейное перемещение строго вдоль продольной оси $X$ на величину $\Delta X$, верифицированную энкодерами и базовыми фронтальными датчиками №1 и №2), изменение показаний дистанции $\Delta D_i$ каждого ToF-сенсора жестко инвариантно к углу его пространственного наклона:

$$\Delta D_i = \Delta X \cdot \cos(\gamma_i)$$

Бортовой вычислитель накапливает массив измерений $\mathcal{M}_i = \{ \Delta X_k, \Delta D_{i,k} \}$ во временном окне калибровки и вычисляет истинные углы оптических осей лучей через тригонометрическое отображение:

$$\gamma_i = \operatorname{sgn}(\gamma_{i, \text{prior}}) \cdot \operatorname{acos}\left( \frac{\sum_{k=1}^{K} \Delta X_k \cdot \Delta D_{i,k}}{\sum_{k=1}^{K} \Delta X_k^2} \right)$$

Где $\operatorname{sgn}(\gamma_{i, \text{prior}})$ — бинарный знак базового полупространства установки датчика согласно конструктивной схеме (отрицательный для правого сектора луча №3, положительный для левого сектора луча №4).

#### 7.3.2. Матричное преобразование ToF-дистанции в декартовы координаты
После успешного завершения фазы самокалибровки и фиксации углов $\gamma_i$, матричный пересчет текущей скалярной ToF-дистанции $D_i$ в декартовы координаты препятствия $\vec{P}_{obs, i}$ в связанной системе координат трактора приобретает адаптивный вид:

$$\vec{P}_{obs, i} = \begin{pmatrix} X_{obs, i} \\ Y_{obs, i} \end{pmatrix} = \begin{pmatrix} x_i + D_i \cdot \cos(\gamma_i) \\ y_i + D_i \cdot \sin(\gamma_i) \end{pmatrix}$$

#### 7.3.3. Зависимость углов перекрестных лучей №3 и №4 на геометрию безопасной зоны маневра
Перекрестные лучи №3 и №4 пересекаются в пространстве перед передним бампером трактора. Точка их геометрического пересечения $\vec{P}_{intersect} = \begin{pmatrix} X_{int} & Y_{int} \end{pmatrix}^T$ является вершиной треугольника зоны гарантированной триангуляции центральных объектов. 

Аналитическое выражение координат точки пересечения лучей из уравнений прямых линий:

$$X_{int} = \frac{y_4 - y_3 + x_3 \tan(\gamma_3) - x_4 \tan(\gamma_4)}{\tan(\gamma_3) - \tan(\gamma_4)}$$
$$Y_{int} = y_3 + (X_{int} - x_3) \cdot \tan(\gamma_3)$$

Вычисленные в процессе самокалибровки углы $\gamma_3$ и $\gamma_4$ динамически проверяются на обеспечение **минимального продольного размера безопасной зоны маневра** ($L_{safe}$). Чтобы трактор успевал отработать тангенциальный обход ножки стула (Раздел 6.2), точка пересечения лучей должна лежать строго дальше радиуса сферы безопасности от переднего габарита шасси $X_{front}$:

$$X_{int} - X_{front} \ge R_{safe}$$

Если в процессе калибровки выявляется, что тригонометрическое условие нарушено (например, датчик сместился физически или угол обзора слишком узкий), система автоматически масштабирует (уменьшает) радиус сферы безопасности $R_{safe}$ и линейную базовую скорость $V_{target}$ в алгоритмах обхода (Раздел 6.4) для сохранения динамической устойчивости платформы.

### 7.4. Критерии полной остановки и блокировки платформы

В отличие от штатного изменения векторов мощностей в процессе обхода препятствий (Раздел 6.4), модель накладывает три жестких логических критерия аварийной ситуации, требующих немедленной полной остановки трактора ($P_{left\_new} = 0$, $P_{right\_new} = 0$) и сброса ШИМ-таймеров в ноль:

1. **Критерий критического сближения (Геометрический упор):**
   Если любой из четырех ToF-датчиков фиксирует сглаженную валидную дистанцию меньше абсолютного физического предела остановки $D_{stop}$:
   $$\exists i \in \{1, 2, 3, 4\} : \bar{D}_i(t) \le D_{stop}$$
   *(Параметр $D_{stop}$ рассчитывается динамически как сумма тормозного пути шасси на текущей скорости и конструктивного вылета бампера относительно оптических центров лазеров).*

2. **Критерий топологического запирания (Проблема «Узких ворот»):**
   При одновременной фиксации препятствий слева и справа, когда аналитический расчет декартовых координат полей (Пункт 6.3.2) показывает, что ширина свободного створа $W_{aperture}$ между препятствиями меньше ширины трактора с учетом динамического зазора безопасности $\Delta B$:
   $$W_{aperture} = ||\vec{P}_{obs, j} - \vec{P}_{obs, k}|| < B + \Delta B$$
   В данном состоянии алгоритм обхода не может сформировать знак инварианта $\Lambda^*$, система блокирует движение для предотвращения заклинивания робота между объектами.

3. **Критерий потери пространственной локализации (IMU Fault):**
   Если расстояние Махаланобиса для вектора ошибок ориентации (Раздел 4.4) пробивает критический верхний порог достоверности в течение длительного времени $\Delta T_{fault} \approx 500$ мс:
   $$\int_{t-\Delta T_{fault}}^{t} [D_M(\tau) > 5.0] \, d\tau = \Delta T_{fault}$$
   Это состояние сигнализирует о полном перевороте шасси, критическом застревании гусеничного привода или непрекращающемся внешнем удержании робота руками. Модель принудительно гасит моторы для предотвращения сгорания силовых ключей BTS7960 от токов короткого замыкания.
