Fogotcheck/TracTorKi/production/TracTorKi.csv

Reference | Qty | Value | DNP | Exclude from BOM | Exclude from Board | Footprint | Datasheet | Type | Voltage | type | voltage | Описание
C1,C30,C31 | 3 | 1µF |  |  |  | Capacitor_SMD:C_1206_3216Metric_Pad1.33x1.80mm_HandSolder |  |  |  |  | X7R, 50V | Unpolarized capacitor
C2,C3,C4,C32,C33,C34,C35,C36,C41,C50,C61 | 11 | 1µF |  |  |  | Capacitor_SMD:C_0603_1608Metric_Pad1.08x0.95mm_HandSolder |  |  |  |  |  | Unpolarized capacitor
C5 | 1 | 100nF |  |  |  | Capacitor_SMD:C_1206_3216Metric_Pad1.33x1.80mm_HandSolder |  |  |  |  | X7R, 50V | Unpolarized capacitor
C6 | 1 | 4.7 µF |  |  |  | Capacitor_SMD:C_1206_3216Metric_Pad1.33x1.80mm_HandSolder |  |  |  |  | X7R, 50V | Unpolarized capacitor
C7 | 1 | 47 nF |  |  |  | Capacitor_SMD:C_1206_3216Metric_Pad1.33x1.80mm_HandSolder |  |  |  |  | X7R, 50V
C8,C9,C10,C11,C13,C14,C15,C19,C22,C25,C26,C27,C40,C48,C57 | 15 | 10µF |  |  |  | Capacitor_SMD:C_1206_3216Metric_Pad1.33x1.80mm_HandSolder |  |  |  |  | 50V,X7R, 50V | Unpolarized capacitor
C12,C21,C23,C24 | 4 | 0.1µF |  |  |  | Capacitor_SMD:C_1206_3216Metric_Pad1.33x1.80mm_HandSolder |  |  |  |  | X7R, 50V | Unpolarized capacitor
C16 | 1 | 1nF |  |  |  | Capacitor_SMD:C_1206_3216Metric_Pad1.33x1.80mm_HandSolder |  |  | 50V |  |  | Unpolarized capacitor
C17,C18 | 2 | 47 nF |  |  |  | Capacitor_SMD:C_0603_1608Metric_Pad1.08x0.95mm_HandSolder |  |  |  |  | X7R, 50V
C20 | 1 | 2.2µF |  |  |  | Capacitor_SMD:C_1206_3216Metric_Pad1.33x1.80mm_HandSolder |  |  |  |  | X7R, 50V
C28,C29,C56 | 3 | 33µF |  |  |  | Capacitor_Tantalum_SMD:CP_EIA-7343-31_Kemet-D_HandSolder |  |  |  |  | 50V | Polarized capacitor
C37,C38,C44,C45,C46,C47,C52,C53,C54,C55,C63,C64,C65,C66 | 14 | 22µF |  |  |  | Capacitor_SMD:C_0603_1608Metric_Pad1.08x0.95mm_HandSolder |  |  |  |  |  | X5R
C39,C43,C51,C62,C67,C68,C69,C135,C136 | 9 | 0.1µF |  |  |  | Capacitor_SMD:C_0603_1608Metric_Pad1.08x0.95mm_HandSolder |  |  |  |  |  | Unpolarized capacitor
C42,C49,C58 | 3 | 220nF |  |  |  | Capacitor_SMD:C_1206_3216Metric_Pad1.33x1.80mm_HandSolder |  |  |  |  | 50V
C70,C71 | 2 | 8.2pF |  |  |  | Capacitor_SMD:C_0603_1608Metric_Pad1.08x0.95mm_HandSolder |  |  |  |  |  | Unpolarized capacitor
C72,C73,C74,C75,C76,C132 | 6 | 100nF |  |  |  | Capacitor_SMD:C_0603_1608Metric_Pad1.08x0.95mm_HandSolder |  |  |  |  |  | Unpolarized capacitor
C77,C78 | 2 | 10pF |  |  |  | Capacitor_SMD:C_0402_1005Metric_Pad0.74x0.62mm_HandSolder |  |  |  |  |  | Unpolarized capacitor
C79,C82,C83,C84,C86,C87,C88,C90,C91,C92,C93,C94,C95,C96,C99,C101,C106,C111,C112,C114,C115,C117,C118,C120,C121,C123,C124,C125,C126,C128 | 30 | 100nF |  |  |  | Capacitor_SMD:C_0402_1005Metric_Pad0.74x0.62mm_HandSolder |  |  |  |  |  | Unpolarized capacitor
C80 | 1 | 470pF |  |  |  | Capacitor_SMD:C_0402_1005Metric_Pad0.74x0.62mm_HandSolder |  |  |  |  |  | Unpolarized capacitor
C81 | 1 | 1uF |  |  |  | Capacitor_SMD:C_0402_1005Metric_Pad0.74x0.62mm_HandSolder |  |  |  |  |  | Unpolarized capacitor
C85 | 1 | 10uF |  |  |  | Capacitor_SMD:C_0603_1608Metric_Pad1.08x0.95mm_HandSolder |  |  |  |  |  | Unpolarized capacitor
C89 | 1 | 1000pF |  |  |  | Capacitor_SMD:C_1812_4532Metric_Pad1.57x3.40mm_HandSolder |  |  |  |  | 2000V | Unpolarized capacitor
C97,C100 | 2 | 10µF |  |  |  | Capacitor_Tantalum_SMD:CP_EIA-3216-18_Kemet-A_HandSolder |  |  |  |  |  | Polarized capacitor
C102,C103,C104,C105 | 4 | 470nF |  |  |  | Capacitor_SMD:C_0402_1005Metric_Pad0.74x0.62mm_HandSolder |  |  |  |  |  | Unpolarized capacitor
C107,C108 | 2 | 2.2uF |  |  |  | Capacitor_SMD:C_0603_1608Metric_Pad1.08x0.95mm_HandSolder |  |  |  | X5R |  | Unpolarized capacitor
C109,C110 | 2 | 1uF |  |  |  | Capacitor_SMD:C_0603_1608Metric_Pad1.08x0.95mm_HandSolder |  |  |  | X5R |  | Unpolarized capacitor
C113,C116,C119,C122 | 4 | 4.7uF |  |  |  | Capacitor_Tantalum_SMD:CP_EIA-3216-18_Kemet-A_HandSolder |  |  |  |  |  | Polarized capacitor
C129 | 1 | 1uF |  |  |  | Capacitor_Tantalum_SMD:CP_EIA-2012-12_Kemet-R_HandSolder |  |  |  |  |  | Polarized capacitor
C130,C131 | 2 | 6.8pF |  |  |  | Capacitor_SMD:C_0603_1608Metric_Pad1.08x0.95mm_HandSolder |  |  |  |  |  | Unpolarized capacitor
C133,C134 | 2 | 1.5pF |  |  |  | Capacitor_SMD:C_0603_1608Metric_Pad1.08x0.95mm_HandSolder |  |  |  | C0G |  | Unpolarized capacitor
D1 | 1 | ESDA25W |  |  |  | Package_TO_SOT_SMD:SOT-323_SC-70 | https://static.chipdip.ru/lib/197/DOC017197250.pdf |  |  |  |  | TVS Diode Array, 5.5V Standoff, 2 Channels, SOT23
D2 | 1 | ESDA25P35-1U1M |  |  |  | TracTorKi:ESDA25P35-1U1M_QFN-2L_1.6x1.0mm | https://static.chipdip.ru/lib/314/DOC018314341.pdf |  |  |  |  | TVS diode
D3 | 1 | BAT54W |  |  |  | Package_TO_SOT_SMD:SOT-323_SC-70 | https://assets.nexperia.com/documents/data-sheet/BAT54W_SER.pdf |  |  |  |  | Schottky barrier diode, SOT-323
D4 | 1 | ESDALC6V1-W2 |  |  |  | Package_TO_SOT_SMD:SOT-323_SC-70 | https://www.st.com/resource/en/datasheet/esdalc6v1w2.pdf |  |  |  |  | Schottky barrier diode, SOT-323
D5 | 1 | LTSTC19HE1WT |  |  |  | LED_SMD:LED_LiteOn_LTST-C19HE1WT | https://static.chipdip.ru/lib/077/DOC034077889.pdf |  |  |  |  | RGB LED, blue/green/red/anode
FB1 | 1 | 600R@100MHz |  |  |  | Inductor_SMD:L_0805_2012Metric_Pad1.05x1.20mm_HandSolder |  |  |  |  |  | Ferrite bead
FB2 | 1 | FBMJ1608HM180NTR |  |  |  | Inductor_SMD:L_0603_1608Metric_Pad1.05x0.95mm_HandSolder |  |  |  |  |  | Ferrite bead
J1 | 1 | USB_C_Receptacle_USB2.0_14P |  |  |  | Connector_USB:USB_C_Receptacle_GCT_USB4085 | https://gct.co/files/drawings/usb4085.pdf |  |  |  |  | USB 2.0-only 14P Type-C Receptacle connector
J2 | 1 | Conn_01x03_Pin |  |  |  | Connector_Molex:Molex_Micro-Latch_53254-0370_1x03_P2.00mm_Horizontal |  |  |  |  |  | Generic connector, single row, 01x03, script generated
J3 | 1 | Conn_01x03_Pin |  |  |  | Connector_PinHeader_2.54mm:PinHeader_1x03_P2.54mm_Vertical |  |  |  |  |  | Generic connector, single row, 01x03, script generated
J4 | 1 | RJ45_Amphenol_RJMG1BD3B8K1ANR |  |  |  | Connector_RJ:RJ45_Amphenol_RJMG1BD3B8K1ANR | https://www.amphenol-cs.com/media/wysiwyg/files/drawing/rjmg1bd3b8k1anr.pdf |  |  |  |  | 1 Port RJ45 Magjack Connector Through Hole 10/100 Base-T, AutoMDIX
J5 | 1 | Micro_SD_Card_Det1 |  |  |  | Connector_Card:microSD_HC_Hirose_DM3AT-SF-PEJM5 | https://datasheet.lcsc.com/lcsc/2110151630_XKB-Connectivity-XKTF-015-N_C381082.pdf |  |  |  |  | Micro SD Card Socket with one card detection pin
J6,J7 | 2 | Molex 502386-0970 |  |  |  | Connector_Molex:Molex_CLIK-Mate_502386-0970_1x09-1MP_P1.25mm_Horizontal | https://www.molex.com/en-us/products/part-detail/5023860970 |  |  |  |  | Molex CLIK-Mate 1.25 mm, 9 circuits, single-row horizontal SMT receptacle
J8,J9 | 2 | Conn_01x02_Pin |  |  |  | Connector_Molex:Molex_Micro-Fit_3.0_43650-0200_1x02_P3.00mm_Horizontal |  |  |  |  |  | Generic connector, single row, 01x02, script generated
J10,J11,J12,J13 | 4 | Conn_01x06_Pin |  |  |  | Connector_Molex:Molex_MicroClasp_55935-0610_1x06_P2.00mm_Horizontal |  |  |  |  |  | Generic connector, single row, 01x06, script generated
J14 | 1 | Conn_ARM_JTAG_SWD_10 |  |  |  | Connector_PinHeader_1.27mm:PinHeader_2x05_P1.27mm_Vertical | http://infocenter.arm.com/help/topic/com.arm.doc.ddi0314h/DDI0314H_coresight_components_trm.pdf |  |  |  |  | Cortex Debug Connector, standard ARM Cortex-M SWD and JTAG interface
J15 | 1 | Conn_01x05_Pin |  |  |  | Connector_Molex:Molex_Micro-Fit_3.0_43650-0500_1x05_P3.00mm_Horizontal |  |  |  |  |  | Generic connector, single row, 01x05, script generated
L1 | 1 | 2.2 µH |  |  |  | Inductor_SMD:L_Chilisin_BMRx00060630 | https://static.chipdip.ru/lib/633/DOC043633403.pdf |  |  |  |  | BMRA000606302R2MA1
L2 | 1 | 8.2µH |  |  |  | Inductor_SMD:L_Chilisin_BMRx00060630 | https://static.chipdip.ru/lib/633/DOC043633403.pdf |  |  |  |  | BMRF000606308R2MA1
L3 | 1 | 15µH |  |  |  | Inductor_SMD:L_Chilisin_BMRx00060630 | https://static.chipdip.ru/lib/633/DOC043633403.pdf |  |  |  |  | BMRA00060630150MA1
L4 | 1 | 6.8µH |  |  |  | Inductor_SMD:L_Chilisin_BMRx00060630 | https://static.chipdip.ru/lib/633/DOC043633403.pdf |  |  |  |  | BMRA000606306R8MA1
Q1,Q2 | 2 | IRFTS9342PBF |  |  |  | Package_SO:TSOP-6_1.65x3.05mm_P0.95mm | https://www.infineon.com/dgdl/irfts9342pbf.pdf?fileId=5546d462533600a40153563aeabc21f3 |  |  |  |  | -5.8A Id, -30V Vds, 40mOhm Rds, P-Channel HEXFET Power MOSFET, TSOP-6
Q3,Q4,Q5 | 3 | CSD17577Q3A |  |  |  | Package_SON:VSON-8_3.3x3.3mm_P0.65mm_NexFET | https://www.ti.com/lit/ds/symlink/csd17577q3a.pdf |  |  |  |  | 35A Id, 30V Vds, NexFET N-Channel Power MOSFET, 4.0mOhm Ron, Qg Typ 12nC, VSON-8 3.3x3.3mm
R1,R16 | 2 | 470 |  |  |  | Resistor_SMD:R_1206_3216Metric_Pad1.30x1.75mm_HandSolder |  |  |  |  |  | Resistor
R2,R6 | 2 | 1K |  |  |  | Resistor_SMD:R_1206_3216Metric_Pad1.30x1.75mm_HandSolder |  |  |  |  |  | Resistor
R3,R5,R7,R8,R9,R34,R36,R39 | 8 | 100K |  |  |  | Resistor_SMD:R_0603_1608Metric_Pad0.98x0.95mm_HandSolder |  |  |  |  |  | Resistor
R4 | 1 | 22K |  |  |  | Resistor_SMD:R_0603_1608Metric_Pad0.98x0.95mm_HandSolder |  |  |  |  |  | Resistor
R10 | 1 | 150K |  |  |  | Resistor_SMD:R_0603_1608Metric_Pad0.98x0.95mm_HandSolder |  |  |  |  |  | Resistor
R11 | 1 | 27K |  |  |  | Resistor_SMD:R_0603_1608Metric_Pad0.98x0.95mm_HandSolder |  |  |  |  |  | Resistor
R12 | 1 | 30.31K |  |  |  | Resistor_SMD:R_0603_1608Metric_Pad0.98x0.95mm_HandSolder |  |  |  |  |  | Resistor
R13 | 1 | 5.24K |  |  |  | Resistor_SMD:R_0603_1608Metric_Pad0.98x0.95mm_HandSolder |  |  |  |  |  | Resistor
R14 | 1 | 100 |  |  |  | Resistor_SMD:R_1206_3216Metric_Pad1.30x1.75mm_HandSolder |  |  |  |  |  | Resistor
R15 | 1 | 2 |  |  |  | Resistor_SMD:R_1206_3216Metric_Pad1.30x1.75mm_HandSolder |  |  |  |  |  | Resistor
R17,R18,R19,R20,R21,R25 | 6 | 1K |  |  |  | Resistor_SMD:R_0603_1608Metric_Pad0.98x0.95mm_HandSolder |  |  |  |  |  | Resistor
R22 | 1 | 1mΩ |  |  |  | Resistor_SMD:R_2512_6332Metric_Pad1.40x3.35mm_HandSolder |  |  |  |  |  | Resistor
R23 | 1 | 4.5K |  |  |  | Resistor_SMD:R_0603_1608Metric_Pad0.98x0.95mm_HandSolder |  |  |  |  |  | Resistor
R24,R26 | 2 | 1M |  |  |  | Resistor_SMD:R_0603_1608Metric_Pad0.98x0.95mm_HandSolder |  |  |  |  |  | Resistor
R27 | 1 | 470K |  |  |  | Resistor_SMD:R_0603_1608Metric_Pad0.98x0.95mm_HandSolder |  |  |  |  |  | Resistor
R28,R30,R47,R48,R49,R50,R51,R52,R53,R54,R58,R61,R62,R63,R71,R73,R74,R75,R77,R78,R79,R80,R81,R82,R83,R84,R85,R86,R87,R88,R89,R90,R115,R116,R117,R118,R129,R131 | 38 | 10K |  |  |  | Resistor_SMD:R_0603_1608Metric_Pad0.98x0.95mm_HandSolder |  |  |  |  |  | Resistor
R29 | 1 | 604K |  |  |  | Resistor_SMD:R_0603_1608Metric_Pad0.98x0.95mm_HandSolder |  |  |  |  |  | Resistor
R31 | 1 | 10K |  |  |  | Resistor_SMD:R_1206_3216Metric_Pad1.30x1.75mm_HandSolder |  |  |  |  |  | Resistor
R32 | 1 | 3.57 |  |  |  | Resistor_SMD:R_0603_1608Metric_Pad0.98x0.95mm_HandSolder |  |  |  |  |  | Resistor
R33 | 1 | 1.15 |  |  |  | Resistor_SMD:R_0603_1608Metric_Pad0.98x0.95mm_HandSolder |  |  |  |  |  | Resistor
R35 | 1 | 24.9K |  |  |  | Resistor_SMD:R_0603_1608Metric_Pad0.98x0.95mm_HandSolder |  |  |  |  |  | Resistor
R37 | 1 | 9.09K |  |  |  | Resistor_SMD:R_0603_1608Metric_Pad0.98x0.95mm_HandSolder |  |  |  |  |  | Resistor
R38,R41 | 2 | 20K |  |  |  | Resistor_SMD:R_0603_1608Metric_Pad0.98x0.95mm_HandSolder |  |  |  |  |  | Resistor
R40,R184,R185 | 3 | 330 |  |  |  | Resistor_SMD:R_0603_1608Metric_Pad0.98x0.95mm_HandSolder |  |  |  |  |  | Resistor
R42 | 1 | 38.3K |  |  |  | Resistor_SMD:R_0603_1608Metric_Pad0.98x0.95mm_HandSolder |  |  |  |  |  | Resistor
R43,R44,R91,R92,R93,R94,R95,R96,R97,R98 | 10 | 100 |  |  |  | Resistor_SMD:R_0603_1608Metric_Pad0.98x0.95mm_HandSolder |  |  |  |  |  | Resistor
R45,R46,R111,R112,R113,R114,R119,R120,R121,R122,R123,R124,R125,R126,R127,R128,R175,R176,R177,R178,R179,R180,R181,R182,R183 | 25 | 4.7K |  |  |  | Resistor_SMD:R_0603_1608Metric_Pad0.98x0.95mm_HandSolder |  |  |  |  |  | Resistor
R55,R56,R57,R60,R132,R133,R134,R135,R136,R137,R138,R139,R140,R141,R142,R143,R144,R145,R146,R147,R148,R149,R150,R151,R152,R153,R154,R155,R156,R157,R158,R159,R160,R161,R162,R163,R164,R165,R166,R167,R168,R169,R170,R171,R172,R173 | 46 | 33 |  |  |  | Resistor_SMD:R_0402_1005Metric_Pad0.72x0.64mm_HandSolder |  |  |  |  |  | Resistor
R59 | 1 | 1.5K |  |  |  | Resistor_SMD:R_0603_1608Metric_Pad0.98x0.95mm_HandSolder |  |  |  |  |  | Resistor
R64 | 1 | 12.1K |  |  |  | Resistor_SMD:R_0603_1608Metric_Pad0.98x0.95mm_HandSolder |  |  |  |  |  | Resistor
R65,R66,R67,R68 | 4 | 49.9 |  |  |  | Resistor_SMD:R_0603_1608Metric_Pad0.98x0.95mm_HandSolder |  |  |  |  |  | Resistor
R69,R70 | 2 | 270 |  |  |  | Resistor_SMD:R_0603_1608Metric_Pad0.98x0.95mm_HandSolder |  |  |  |  |  | Resistor
R72 | 1 | 1M |  |  |  | Resistor_SMD:R_1206_3216Metric_Pad1.30x1.75mm_HandSolder |  |  |  |  |  | Resistor
R99,R102,R105,R106 | 4 | 1K |  |  |  | Resistor_SMD:R_0402_1005Metric_Pad0.72x0.64mm_HandSolder |  |  |  |  |  | Resistor
R100,R103,R107,R109 | 4 | 15K |  |  |  | Resistor_SMD:R_0402_1005Metric_Pad0.72x0.64mm_HandSolder |  |  |  |  |  | Resistor
R101,R104,R108,R110 | 4 | 1.2K |  |  |  | Resistor_SMD:R_0402_1005Metric_Pad0.72x0.64mm_HandSolder |  |  |  |  |  | Resistor
R130 | 1 | 10K |  |  |  | Resistor_SMD:R_0805_2012Metric_Pad1.20x1.40mm_HandSolder |  |  |  |  |  | Resistor
R174 | 1 | 0 |  |  |  | Resistor_SMD:R_0402_1005Metric_Pad0.72x0.64mm_HandSolder |  |  |  |  |  | Resistor
SW1 | 1 | CK_KMS2xxG |  |  |  | Button_Switch_SMD:SW_SPST_CK_KMS2xxGP | https://www.ckswitches.com/media/1482/kms.pdf |  |  |  |  | Microminiature SMT Side Actuated, 4.2 x 2.8 x 1.42mm, without pegs, with shield pin
U1 | 1 | BQ25798RQMR |  |  |  | Package_DFN_QFN:Texas_RQM0029A_VQFN-29_4x4mm_P0.4mm | https://www.ti.com/lit/ds/symlink/bq25798.pdf |  |  |  |  | I2C controlled, 5A Buck-Boost battery charger (1-4 cell, Li-Ion / Li-Polymer), USB BC1.2 / HVDCP detection, 3.6..24V VBUS, 3..18.8V charge voltage regulation, 0.75..1.5 MHz, VQFN-29 (Texas RQM0029A)
U2 | 1 | STUSB4500QTR |  |  |  | Package_DFN_QFN:QFN-24-1EP_4x4mm_P0.5mm_EP2.7x2.7mm | https://www.st.com/resource/en/datasheet/stusb4500.pdf |  |  |  |  | Stand-alone USB PD controller (with sink Auto-run mode), QFN-24
U3 | 1 | BQ7791500PWR |  |  |  | Package_SO:TSSOP-24_4.4x7.8mm_P0.65mm | https://static.chipdip.ru/lib/079/DOC043079178.pdf
U4,U5,U6 | 3 | LMR33630ADDA |  |  |  | Package_SO:Texas_HSOP-8-1EP_3.9x4.9mm_P1.27mm_ThermalVias | http://www.ti.com/lit/ds/symlink/lmr33630.pdf |  |  |  |  | Simple Switcher Synchronous Buck Regulator, Vin=3.8-36V, Iout=3A, F=400kHz, Adjustable output voltage, HSOP-8
U7 | 1 | TPS7A9201DSKR |  |  |  | Package_DFN_QFN:Texas_S-PDSO-N10_EP1.2x2mm | https://www.ti.com/lit/ds/symlink/tps7a92.pdf |  |  |  |  | Texas Instruments TPS7A92 Low Noise Low Dropout Voltage Regulator device is a low-noise (4.8µV RMS ), low-dropout (LDO) voltage regulator capable of sourcing 2A with only 180mV of dropout. The TPS7A92 output is adjustable with external resistors from 0.8V to 5.2V. The TPS7A92 wide input-voltage range supports operation as low as 1.4V and up to 6.5V. With 1% output voltage accuracy (over the line, load, and temperature) and soft-start capabilities to reduce inrush current, the TPS7A92 is ideal for powering sensitive analog low-voltage devices. These types of devices include voltage-controlled oscillators (VCOs), analog-to-digital converters (ADCs), digital-to-analog converters (DACs), high-end processors, and field-programmable gate arrays (FPGAs). The TPS7A92 is designed to power noise-sensitive components such as those found in high-speed communication, video, medical, or test, and measurement applications.
U8 | 1 | IP4252CZ12 |  |  |  | Package_SON:Nexperia_HUSON-12_USON-12-1EP_1.35x2.5mm_P0.4mm_EP0.4x2mm | https://assets.nexperia.com/documents/data-sheet/IP4251_52_53_54-TTL.pdf |  |  |  |  | 6 channel EMI filters with integrated ESD protection, 12 pF, 40 Ohm
U9 | 1 | LAN8742A-CZ-TR |  |  |  | Package_DFN_QFN:VQFN-24-1EP_4x4mm_P0.5mm_EP2.5x2.5mm_ThermalVias | http://ww1.microchip.com/downloads/en/DeviceDoc/8742a.pdf |  |  |  |  | LAN8720 Ethernet PHY with RMII interface, QFN-24
U10 | 1 | BME280 |  |  |  | Package_LGA:Bosch_LGA-8_2.5x2.5mm_P0.65mm_ClockwisePinNumbering | https://www.bosch-sensortec.com/media/boschsensortec/downloads/datasheets/bst-bme280-ds002.pdf |  |  |  |  | 3-in-1 sensor, humidity, pressure, temperature, I2C and SPI interface, 1.71-3.6V, LGA-8
U11 | 1 | BNO085 |  |  |  | Package_LGA:LGA-28_5.2x3.8mm_P0.5mm | https://static.chipdip.ru/lib/063/DOC057063187.pdf |  |  |  |  | Intelligent 9-axis absolute orientation sensor, LGA-28
U12 | 1 | USBLC6-4SC6 |  |  |  | Package_TO_SOT_SMD:SOT-23-6 | https://www.st.com/resource/en/datasheet/usblc6-4.pdf |  |  |  |  | Very low capacitance ESD protection diode, 4 data-line, SOT-23-6
U13 | 1 | IS42S16160J-7TLI |  |  |  | Package_SO:TSOP-II-54_22.2x10.16mm_P0.8mm | http://www.issi.com/WW/pdf/42-45S16400J.pdf |  |  |  |  | 64Mb Synchronous DRAM, 1 Mb x 16 b x 4 Banks, Alloy42 leadframe plated with matte Sn, TSOP-II-54
U15 | 1 | 74HCT245D |  |  |  | Package_SO:SOIC-20W_7.5x12.8mm_P1.27mm | https://static.chipdip.ru/lib/567/DOC059567337.pdf |  |  |  |  | Octal BUS Transceivers, 3-State outputs
U16 | 1 | TLV9004xRUCR |  |  |  | Package_DFN_QFN:Texas_S-PX2QFN-14 | http://www.ti.com/lit/ds/symlink/tlv9004.pdf |  |  |  |  | Low-Power, Quad-Operational Amplifiers, Texas S-PX2QFN-14
U17 | 1 | PCA9516APW |  |  |  | Package_SO:TSSOP-16_4.4x5mm_P0.65mm | http://www.nxp.com/docs/en/data-sheet/PCA9518.pdf |  |  |  |  | 5 channels I2C Hub, SO/TSSOP16
U18 | 1 | STM32H743ZIT6 |  |  |  | ST_stm32H743zit6:LQFP144-20x20mm | https://www.st.com/resource/en/datasheet/stm32h743vi.pdf | Type |  |  |  | High-performance and DSP with DP-FPU, Arm Cortex-M7 MCU with 2MBytes of Flash memory, 1MB RAM, 480 MHz CPU, Art Accelerator, L1 cache, external memory interface, large set of peripherals
U19 | 1 | TCA9517ADGK |  |  |  | Package_SO:VSSOP-8_3x3mm_P0.65mm | https://www.ti.com/lit/ds/symlink/tca9517a.pdf |  |  |  |  | Level-Translating I2C Bus Buffer/Repeater, VSSOP-8
Y1,Y4 | 2 | NX3215SA-32.768KHZ-EXS00A-MU00525 |  |  |  | Crystal:Crystal_SMD_3215-2Pin_3.2x1.5mm | https://static.chipdip.ru/lib/014/DOC004014433.pdf |  |  |  |  | STD-MUA-14,Two pin crystal
Y2 | 1 | NX3225HA-25MHz-EXS00A-CH00343 |  |  |  | Crystal:Crystal_SMD_3225-4Pin_3.2x2.5mm_HandSoldering |  |  |  |  |  | Four pin crystal, GND on pins 2 and 4
Y3 | 1 | NX2016SA 25MHz |  |  |  | Crystal:Crystal_SMD_2016-4Pin_2.0x1.6mm | https://static.chipdip.ru/lib/174/DOC042174554.pdf |  |  |  |  | NX2016SA-25MHZ-STD-CZS-2
