Fogotcheck/TracTorKi/TracTorKi.kicad_pcb

## KiCad design TracTorKi.kicad_pcb (2026-11-12)

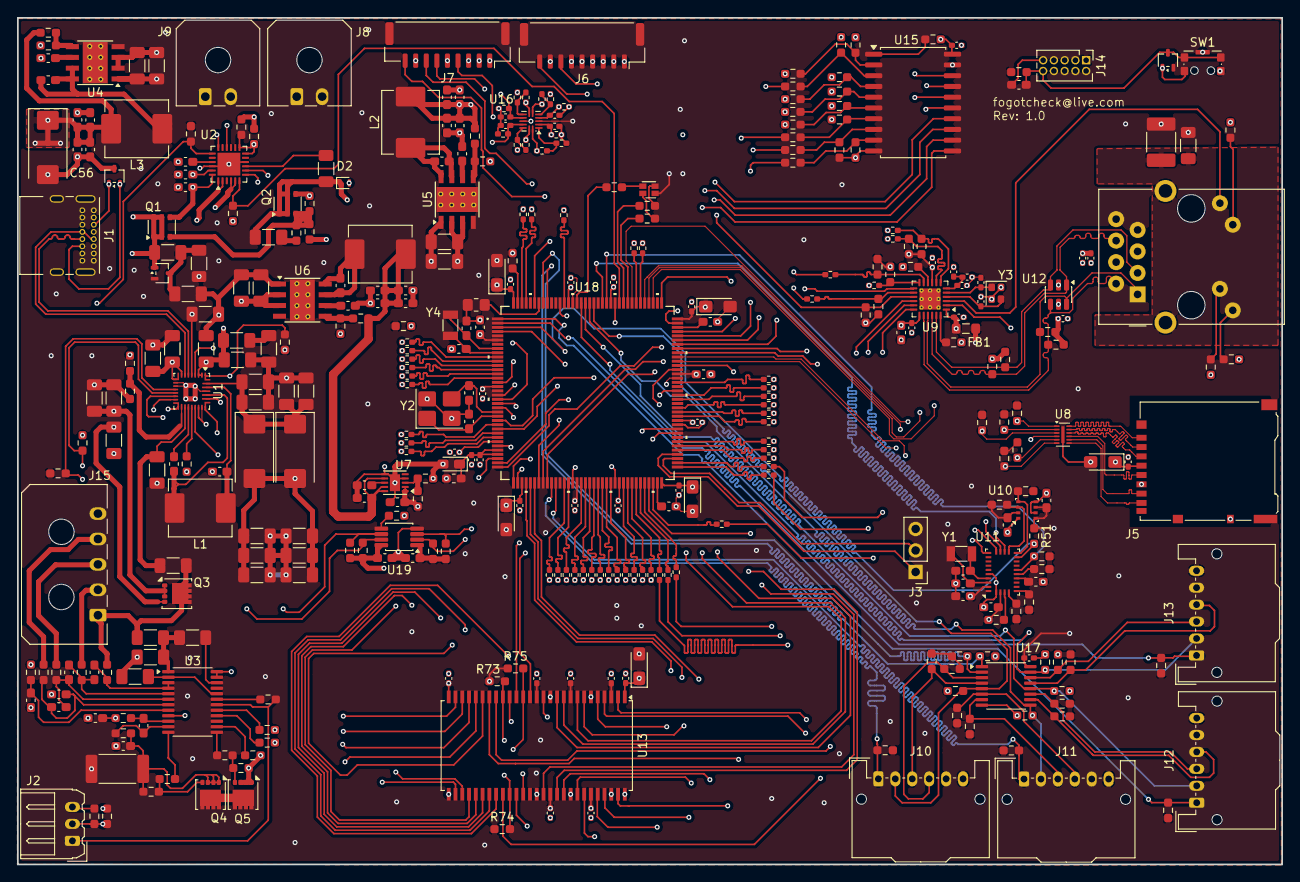
[picture p1: board TracTorKi.kicad_pcb from above]

Board: 6 copper layers, 149.4 x 100.0 mm, 370 parts (0 on the bottom side), 295 nets.

Parts:
C1, C30, C31: 1µF; C_1206_3216Metric_Pad1.33x1.80mm_HandSolder
C2, C3, C4, C32, C33, C34, C35, C36, C41, C50, C61: 1µF; C_0603_1608Metric_Pad1.08x0.95mm_HandSolder
C5: 100nF; C_1206_3216Metric_Pad1.33x1.80mm_HandSolder
C6: 4.7 µF; C_1206_3216Metric_Pad1.33x1.80mm_HandSolder
C7: 47 nF; C_1206_3216Metric_Pad1.33x1.80mm_HandSolder
C8, C9, C10, C11, C13, C14, C15, C19, C22, C25, C26, C27, C40, C48, C57: 10µF; C_1206_3216Metric_Pad1.33x1.80mm_HandSolder
C12, C21, C23, C24: 0.1µF; C_1206_3216Metric_Pad1.33x1.80mm_HandSolder
C16: 1nF; C_1206_3216Metric_Pad1.33x1.80mm_HandSolder
C17, C18: 47 nF; C_0603_1608Metric_Pad1.08x0.95mm_HandSolder
C20: 2.2µF; C_1206_3216Metric_Pad1.33x1.80mm_HandSolder
C28, C29, C56: 33µF; CP_EIA-7343-31_Kemet-D_HandSolder
C37, C38, C44, C45, C46, C47, C52, C53, C54, C55, C63, C64, C65, C66: 22µF; C_0603_1608Metric_Pad1.08x0.95mm_HandSolder
C39, C43, C51, C62, C67, C68, C69, C135, C136: 0.1µF; C_0603_1608Metric_Pad1.08x0.95mm_HandSolder
C42, C49, C58: 220nF; C_1206_3216Metric_Pad1.33x1.80mm_HandSolder
C70, C71: 8.2pF; C_0603_1608Metric_Pad1.08x0.95mm_HandSolder
C72, C73, C74, C75, C76, C132: 100nF; C_0603_1608Metric_Pad1.08x0.95mm_HandSolder
C77, C78: 10pF; C_0402_1005Metric_Pad0.74x0.62mm_HandSolder
C79, C82, C83, C84, C86, C87, C88, C90, C91, C92, C93, C94, C95, C96, C99, C101, C106, C111, C112, C114, C115, C117, C118, C120, C121, C123, C124, C125, C126, C128: 100nF; C_0402_1005Metric_Pad0.74x0.62mm_HandSolder
C80: 470pF; C_0402_1005Metric_Pad0.74x0.62mm_HandSolder
C81: 1uF; C_0402_1005Metric_Pad0.74x0.62mm_HandSolder
C85: 10uF; C_0603_1608Metric_Pad1.08x0.95mm_HandSolder
C89: 1000pF; C_1812_4532Metric_Pad1.57x3.40mm_HandSolder
C97, C100: 10µF; CP_EIA-3216-18_Kemet-A_HandSolder
C102, C103, C104, C105: 470nF; C_0402_1005Metric_Pad0.74x0.62mm_HandSolder
C107, C108: 2.2uF; C_0603_1608Metric_Pad1.08x0.95mm_HandSolder
C109, C110: 1uF; C_0603_1608Metric_Pad1.08x0.95mm_HandSolder
C113, C116, C119, C122: 4.7uF; CP_EIA-3216-18_Kemet-A_HandSolder
C129: 1uF; CP_EIA-2012-12_Kemet-R_HandSolder
C130, C131: 6.8pF; C_0603_1608Metric_Pad1.08x0.95mm_HandSolder
C133, C134: 1.5pF; C_0603_1608Metric_Pad1.08x0.95mm_HandSolder
D1: ESDA25W; SOT-323_SC-70
D2: ESDA25P35-1U1M; ESDA25P35-1U1M_QFN-2L_1.6x1.0mm
D3: BAT54W; SOT-323_SC-70
D4: ESDALC6V1-W2; SOT-323_SC-70
D5: LTSTC19HE1WT; LED_LiteOn_LTST-C19HE1WT
FB1: 600R@100MHz; L_0805_2012Metric_Pad1.05x1.20mm_HandSolder
FB2: FBMJ1608HM180NTR; L_0603_1608Metric_Pad1.05x0.95mm_HandSolder
J1: USB_C_Receptacle_USB2.0_14P; USB_C_Receptacle_GCT_USB4085
J2: Conn_01x03_Pin; Molex_Micro-Latch_53254-0370_1x03_P2.00mm_Horizontal
J3: Conn_01x03_Pin; PinHeader_1x03_P2.54mm_Vertical
J4: RJ45_Amphenol_RJMG1BD3B8K1ANR
J5: Micro_SD_Card_Det1; microSD_HC_Hirose_DM3AT-SF-PEJM5
J6, J7: Molex 502386-0970; Molex_CLIK-Mate_502386-0970_1x09-1MP_P1.25mm_Horizontal
J8, J9: Conn_01x02_Pin; Molex_Micro-Fit_3.0_43650-0200_1x02_P3.00mm_Horizontal
J10, J11, J12, J13: Conn_01x06_Pin; Molex_MicroClasp_55935-0610_1x06_P2.00mm_Horizontal
J14: Conn_ARM_JTAG_SWD_10; PinHeader_2x05_P1.27mm_Vertical
J15: Conn_01x05_Pin; Molex_Micro-Fit_3.0_43650-0500_1x05_P3.00mm_Horizontal
L1: 2.2 µH; L_Chilisin_BMRx00060630
L2: 8.2µH; L_Chilisin_BMRx00060630
L3: 15µH; L_Chilisin_BMRx00060630
L4: 6.8µH; L_Chilisin_BMRx00060630
Q1, Q2: IRFTS9342PBF; TSOP-6_1.65x3.05mm_P0.95mm
Q3, Q4, Q5: CSD17577Q3A; VSON-8_3.3x3.3mm_P0.65mm_NexFET
R1, R16: 470; R_1206_3216Metric_Pad1.30x1.75mm_HandSolder
R2, R6: 1K; R_1206_3216Metric_Pad1.30x1.75mm_HandSolder
R3, R5, R7, R8, R9, R34, R36, R39: 100K; R_0603_1608Metric_Pad0.98x0.95mm_HandSolder
R4: 22K; R_0603_1608Metric_Pad0.98x0.95mm_HandSolder
R10: 150K; R_0603_1608Metric_Pad0.98x0.95mm_HandSolder
R11: 27K; R_0603_1608Metric_Pad0.98x0.95mm_HandSolder
R12: 30.31K; R_0603_1608Metric_Pad0.98x0.95mm_HandSolder
R13: 5.24K; R_0603_1608Metric_Pad0.98x0.95mm_HandSolder
R14: 100; R_1206_3216Metric_Pad1.30x1.75mm_HandSolder
R15: 2; R_1206_3216Metric_Pad1.30x1.75mm_HandSolder
R17, R18, R19, R20, R21, R25: 1K; R_0603_1608Metric_Pad0.98x0.95mm_HandSolder
R22: 1mΩ; R_2512_6332Metric_Pad1.40x3.35mm_HandSolder
R23: 4.5K; R_0603_1608Metric_Pad0.98x0.95mm_HandSolder
R24, R26: 1M; R_0603_1608Metric_Pad0.98x0.95mm_HandSolder
R27: 470K; R_0603_1608Metric_Pad0.98x0.95mm_HandSolder
R28, R30, R47, R48, R49, R50, R51, R52, R53, R54, R58, R61, R62, R63, R71, R73, R74, R75, R77, R78, R79, R80, R81, R82, R83, R84, R85, R86, R87, R88, R89, R90, R115, R116, R117, R118, R129, R131: 10K; R_0603_1608Metric_Pad0.98x0.95mm_HandSolder
R29: 604K; R_0603_1608Metric_Pad0.98x0.95mm_HandSolder
R31: 10K; R_1206_3216Metric_Pad1.30x1.75mm_HandSolder
R32: 3.57; R_0603_1608Metric_Pad0.98x0.95mm_HandSolder
R33: 1.15; R_0603_1608Metric_Pad0.98x0.95mm_HandSolder
R35: 24.9K; R_0603_1608Metric_Pad0.98x0.95mm_HandSolder
R37: 9.09K; R_0603_1608Metric_Pad0.98x0.95mm_HandSolder
R38, R41: 20K; R_0603_1608Metric_Pad0.98x0.95mm_HandSolder
R40, R184, R185: 330; R_0603_1608Metric_Pad0.98x0.95mm_HandSolder
R42: 38.3K; R_0603_1608Metric_Pad0.98x0.95mm_HandSolder
R43, R44, R91, R92, R93, R94, R95, R96, R97, R98: 100; R_0603_1608Metric_Pad0.98x0.95mm_HandSolder
R45, R46, R111, R112, R113, R114, R119, R120, R121, R122, R123, R124, R125, R126, R127, R128, R175, R176, R177, R178, R179, R180, R181, R182, R183: 4.7K; R_0603_1608Metric_Pad0.98x0.95mm_HandSolder
R55, R56, R57, R60, R132, R133, R134, R135, R136, R137, R138, R139, R140, R141, R142, R143, R144, R145, R146, R147, R148, R149, R150, R151, R152, R153, R154, R155, R156, R157, R158, R159, R160, R161, R162, R163, R164, R165, R166, R167, R168, R169, R170, R171, R172, R173: 33; R_0402_1005Metric_Pad0.72x0.64mm_HandSolder
R59: 1.5K; R_0603_1608Metric_Pad0.98x0.95mm_HandSolder
R64: 12.1K; R_0603_1608Metric_Pad0.98x0.95mm_HandSolder
R65, R66, R67, R68: 49.9; R_0603_1608Metric_Pad0.98x0.95mm_HandSolder
R69, R70: 270; R_0603_1608Metric_Pad0.98x0.95mm_HandSolder
R72: 1M; R_1206_3216Metric_Pad1.30x1.75mm_HandSolder
R99, R102, R105, R106: 1K; R_0402_1005Metric_Pad0.72x0.64mm_HandSolder
R100, R103, R107, R109: 15K; R_0402_1005Metric_Pad0.72x0.64mm_HandSolder
R101, R104, R108, R110: 1.2K; R_0402_1005Metric_Pad0.72x0.64mm_HandSolder
R130: 10K; R_0805_2012Metric_Pad1.20x1.40mm_HandSolder
R174: 0; R_0402_1005Metric_Pad0.72x0.64mm_HandSolder
SW1: CK_KMS2xxG; SW_SPST_CK_KMS2xxGP
U1: BQ25798RQMR; Texas_RQM0029A_VQFN-29_4x4mm_P0.4mm
U2: STUSB4500QTR; QFN-24-1EP_4x4mm_P0.5mm_EP2.7x2.7mm
U3: BQ7791500PWR; TSSOP-24_4.4x7.8mm_P0.65mm
U4, U5, U6: LMR33630ADDA; Texas_HSOP-8-1EP_3.9x4.9mm_P1.27mm_ThermalVias
U7: TPS7A9201DSKR; Texas_S-PDSO-N10_EP1.2x2mm
U8: IP4252CZ12; Nexperia_HUSON-12_USON-12-1EP_1.35x2.5mm_P0.4mm_EP0.4x2mm
U9: LAN8742A-CZ-TR; VQFN-24-1EP_4x4mm_P0.5mm_EP2.5x2.5mm_ThermalVias
U10: BME280; Bosch_LGA-8_2.5x2.5mm_P0.65mm_ClockwisePinNumbering
U11: BNO085; LGA-28_5.2x3.8mm_P0.5mm
U12: USBLC6-4SC6; SOT-23-6
U13: IS42S16160J-7TLI; TSOP-II-54_22.2x10.16mm_P0.8mm
U15: 74HCT245D; SOIC-20W_7.5x12.8mm_P1.27mm
U16: TLV9004xRUCR; Texas_S-PX2QFN-14
U17: PCA9516APW; TSSOP-16_4.4x5mm_P0.65mm
U18: STM32H743ZIT6; LQFP144-20x20mm
U19: TCA9517ADGK; VSSOP-8_3x3mm_P0.65mm
Y1, Y4: NX3215SA-32.768KHZ-EXS00A-MU00525; Crystal_SMD_3215-2Pin_3.2x1.5mm
Y2: NX3225HA-25MHz-EXS00A-CH00343; Crystal_SMD_3225-4Pin_3.2x2.5mm_HandSoldering
Y3: NX2016SA 25MHz; Crystal_SMD_2016-4Pin_2.0x1.6mm

Connections:
3.6V: C38.1, C63.1, C64.1, C65.1, C66.1, L4.2, R39.1, U7.7 (EN), U7.9 (IN), U7.10 (IN)
+2V7: C4.1, R7.1, R8.1, U2.12 (ADDR0), U2.13 (ADDR1), U2.23 (VREG_2V7)
+3.3V: C37.1, C72.1, C73.1, C75.1, C76.1, C79.1, C90.1, C91.1, C92.1, C93.1, C94.1, C95.1, C96.1, C97.1, C99.1, C100.1, C106.1, C109.1, C110.1, C111.1, C112.1, C113.1, C114.1, C115.1, C116.1, C117.1, C118.1, C119.1, C120.1, C121.1, C122.1, C123.1, C124.1, C125.1, C136.1, D5.4 (A), FB1.1, FB2.1, J5.4 (VDD), J10.6, J11.6, J12.6, J13.6, J14.1 (VTref), R32.2, R45.1, R46.1, R47.1, R48.1, R49.1, R50.1, R51.1, R52.1, R53.1, R54.1, R58.1, R59.1, R61.1, R62.1, R73.1, R74.1, R75.1, R77.1, R78.1, R79.1, R80.1, R81.1, R111.1, R112.1, R113.1, R114.1, R119.1, R120.1, R121.1, R122.1, R123.1, R124.1, R125.1, R126.1, R127.1, R128.1, R129.1, R131.1, R175.1, R176.1, R180.1, R181.1, R182.1, R183.1, U7.1 (OUT), U7.2 (OUT), U9.9 (VDDIO), U10.2 (CSB), U10.6 (VDDIO), U10.8 (VDD), U11.3 (VDD), U11.28 (VDDIO), U13.1 (VDD), U13.3 (VDDQ), U13.9 (VDDQ), U13.14 (VDD), U13.27 (VDD), U13.43 (VDDQ), U13.49 (VDDQ), U16.3 (V+), U17.16 (VCC), U18.6 (VBAT), U18.17 (VDD), U18.30 (VDD), U18.39 (VDD), U18.52 (VDD), U18.62 (VDD), U18.72 (VDD), U18.84 (VDD), U18.95 (VDD33USB), U18.108 (VDD), U18.121 (VDD), U18.131 (VDD), U18.144 (VDD), U19.1 (VCCA)
+5V: C44.1, C45.1, C46.1, C47.1, C101.1, C135.1, J6.1, J7.1, L2.2, R34.1, R90.1, R177.1, R178.1, R179.1, U15.20 (VCC), U19.8 (VCCB)
+12V: C52.1, C53.1, C54.1, C55.1, C56.1, J8.2, J9.2, L3.2, R36.1
+20V: C5.1, C19.1, C21.1, C22.1, C23.1, D2.1 (K), Q2.1 (D), Q2.2 (D), Q2.5 (D), Q2.6 (D), R6.1, R15.1, U1.2 (VBUS), U1.3 (VBUS), U1.8 (VAC2), U1.9 (VAC1)
/Ethernet/RD_N: J4.R6 (RD-), R65.2, U9.22 (RXN), U12.1 (I/O1)
/Ethernet/RD_P: J4.R3 (RD+), R66.2, U9.23 (RXP), U12.3 (I/O2)
/Ethernet/TD_N: J4.R2 (TD-), R67.2, U9.20 (TXN), U12.4 (I/O3)
/Ethernet/TD_P: J4.R1 (TD+), R68.2, U9.21 (TXP), U12.6 (I/O4)
BAT_1: J15.4, R20.1
BAT_2: J15.3, R19.1
BAT_3: J15.2, R18.1
BAT_4: J15.1, Q3.5 (D), R14.1, R16.1, R17.1
BAT_GND: C35.1, C36.2, C67.1, C67.2, C69.1, J15.5, R21.1, R22.1, R28.2, R29.2, R44.2, U3.9 (VSS), U3.23 (CTRC), U3.24 (CTRD)
BNO085_BOOTN: R47.2, U11.4 (BOOTN)
BNO085_CLK: U11.19 (H_SCLK), U18.41 (PA5)
BNO085_CLKSEL0: R50.2, U11.10 (CLKSEL0)
BNO085_CS: U11.18 (H_CSN), U18.40 (PA4)
BNO085_INT: R51.2, U11.14 (INT), U18.3 (PE4)
BNO085_MISO: U11.20 (H_MISO), U18.42 (PA6)
BNO085_MOSI: U11.17 (H_MOSI), U18.123 (PD7)
BNO085_NRST: R52.2, U11.11 (~RESET), U18.122 (PD6)
BNO085_PS0: R49.2, U11.6 (PS0)
BNO085_PS1: R48.2, U11.5 (PS1)
BQ25798_CE: R41.1, U1.13 (~CE), U18.96 (PC6)
BQ25798_INT: R183.2, U1.21 (~INT), U18.4 (PE5)
BQ25798_NTC: J2.2, R12.1, R13.2, U1.16 (TS)
BQ25798_QON: R181.2, U1.12 (~QON), U18.91 (PG6)
BQ25798_SCL: R179.2, U1.14 (SCL), U2.7 (SCL), U19.7 (SCLB)
BQ25798_SDA: R178.2, U1.15 (SDA), U2.8 (SDA), U19.6 (SDAB)
BQ25798_STAT: R182.2, U1.1 (STAT), U18.100 (PA8)
BQ77915_NTC: J2.1, R30.2, U3.18 (TS)
BQ77915_SHUNT: C69.2, Q4.1 (S), Q4.2 (S), Q4.3 (S), R22.2, R24.2, R43.2
BQ77915_SRN: C68.2, R43.1, U3.11 (SRN)
BQ77915_SRP: C68.1, R44.1, U3.10 (SRP)
BTS7960_EN_L1: J6.7, U15.16 (B2)
BTS7960_EN_L1_TO_MCU: R96.1, U18.101 (PA9)
BTS7960_EN_L2: J7.7, U15.12 (B6)
BTS7960_EN_L2_TO_MCU: R92.1, U18.103 (PA11)
BTS7960_EN_R1: J6.9, U15.15 (B3)
BTS7960_EN_R1_TO_MCU: R95.1, U18.102 (PA10)
BTS7960_EN_R2: J7.9, U15.11 (B7)
BTS7960_EN_R2_TO_MCU: R91.1, U18.104 (PA12)
BTS7960_IS_L1: C102.1, J6.6, R99.1, U16.2 (+)
BTS7960_IS_L1_TO_MCU: R100.1, U16.14, U18.19 (PF7)
BTS7960_IS_L2: C104.1, J7.6, R105.1, U16.11 (+)
BTS7960_IS_L2_TO_MCU: R107.1, U16.13, U18.20 (PF8)
BTS7960_IS_R1: C103.1, J6.8, R102.1, U16.4 (+)
BTS7960_IS_R1_TO_MCU: R103.1, U16.6, U18.21 (PF9)
BTS7960_IS_R2: C105.1, J7.8, R106.1, U16.9 (+)
BTS7960_IS_R2_TO_MCU: R109.1, U16.7, U18.22 (PF10)
BTS7960_PWM_L1: J6.3, U15.18 (B0)
BTS7960_PWM_L1_TO_MCU: R98.1, U18.34 (PA0-WKUP)
BTS7960_PWM_L2: J7.3, U15.14 (B4)
BTS7960_PWM_L2_TO_MCU: R94.1, U18.69 (PB10)
BTS7960_PWM_R1: J6.4, U15.17 (B1)
BTS7960_PWM_R1_TO_MCU: R97.1, U18.133 (PB3)
BTS7960_PWM_R2: J7.4, U15.13 (B5)
BTS7960_PWM_R2_TO_MCU: R93.1, U18.37 (PA3)
ETH.LAN8742A_CRS_DV: R57.1, U18.43 (PA7)
ETH.LAN8742A_MDC: U9.13 (MDC), U18.27 (PC1)
ETH.LAN8742A_MDIO: R174.1, U18.36 (PA2)
ETH.LAN8742A_NRST: R62.2, U9.15 (~RST), U18.139 (PB8)
ETH.LAN8742A_REF_CLK: R60.1, U18.35 (PA1)
ETH.LAN8742A_RXD0: R56.1, U18.44 (PC4)
ETH.LAN8742A_RXD1: R55.1, U18.45 (PC5)
ETH.LAN8742A_TXD0: R172.1, U9.17 (TXD0)
ETH.LAN8742A_TXD1: R173.1, U9.18 (TXD1)
ETH.LAN8742A_TXEN: R171.1, U9.16 (TXEN)
ETH_CRS_DV: R57.2, R58.2, U9.11 (CRS_DV/MODE2)
ETH_LED_G: J4.L4, R71.1, U9.2 (LED2/~INTSEL)
ETH_LED_Y: J4.L1, U9.3 (LED1/REGOFF)
ETH_MDIO: R59.2, R174.2, U9.12 (MDIO)
ETH_REF_CLK: R60.2, R61.2, U9.14 (~INT/REFCLKO)
ETH_RXD0: R53.2, R56.2, U9.8 (RXD0/MODE0)
ETH_RXD1: R54.2, R55.2, U9.7 (RXD1/MODE1)
ETH_RXER_PHYAD0: R63.1, U9.10 (RXER/PHYAD0)
GND: C1.2, C2.2, C3.2, C4.2, C6.2, C7.2, C8.2, C9.2, C10.2, C11.2, C12.2, C13.2, C14.2, C15.2, C16.2, C19.2, C20.2, C21.2, C22.2, C23.2, C24.2, C25.2, C26.2, C27.2, C28.2, C29.2, C30.2, C31.1, C37.2, C38.2, C39.2, C40.2, C41.2, C42.2, C44.2, C45.2, C46.2, C47.2, C48.2, C49.2, C50.2, C52.2, C53.2, C54.2, C55.2, C56.2, C57.2, C58.2, C61.2, C63.2, C64.2, C65.2, C66.2, C70.2, C71.2, C72.2, C73.2, C74.2, C75.2, C76.2, C77.2, C78.2, C79.2, C80.2, C81.2, C82.2, C83.2, C84.2, C85.2, C86.2, C87.2, C88.2, C89.2, C90.2, C91.2, C92.2, C93.2, C94.2, C95.2, C96.2, C97.2, C99.2, C100.2, C101.2, C102.2, C103.2, C104.2, C105.2, C106.2, C107.2, C108.2, C109.2, C110.2, C111.2, C112.2, C113.2, C114.2, C115.2, C116.2, C117.2, C118.2, C119.2, C120.2, C121.2, C122.2, C123.2, C124.2, C125.2, C126.2, C128.2, C129.2, C130.2, C131.2, C132.2, C133.2, C134.2, C135.2, C136.2, D1.3 (A), D2.2 (A), D4.1 (A), J1.A1 (GND), J1.A12 (GND), J1.B1 (GND), J1.B12 (GND), J1.S1 (SHIELD), J2.3, J3.3, J5.6 (VSS), J5.10 (SHIELD), J6.2, J6.5, J7.2, J7.5, J8.1, J9.1, J10.5, J11.5, J12.5, J13.5, J14.3 (GND), J14.5 (GND), J14.9 (GNDDetect), Q5.1 (S), Q5.2 (S), Q5.3 (S), R7.2, R8.2, R10.2, R11.2, R12.2, R26.2, R27.2, R33.2, R35.2, R37.2, R38.2, R41.2, R42.2, R63.2, R64.2, R69.2, R70.2, R71.2, R72.1, R82.2, R83.2, R84.2, R85.2, R86.2, R87.2, R88.2, R89.2, R99.2, R101.2, R102.2, R104.2, R105.2, R106.2, R108.2, R110.2, R115.2, R116.2, R117.2, R118.2, R130.2, SW1.2, SW1.SH (B), U1.10 (ACDRV2), U1.11 (ACDRV1), U1.27 (GND), U2.10 (GND), U2.22 (VSYS), U2.25 (GND), U4.1 (GND), U4.9 (GND), U5.1 (GND), U5.9 (GND), U6.1 (GND), U6.9 (GND), U7.4 (GND), U7.6 (SS_CTRL), U7.11 (GND), U8.13 (GND), U9.25 (VSS), U10.1 (GND), U10.5 (SDO), U10.7 (GND), U11.2 (GND), U11.25 (GNDIO), U12.2 (GND), U13.6 (GNDQ), U13.12 (GNDQ), U13.28 (GND), U13.41 (GND), U13.46 (GNDQ), U13.52 (GNDQ), U13.54 (GND), U15.10 (GND), U15.19 (CE), U16.10 (V-), U17.8 (GND), U18.16 (VSS), U18.31 (VSSA), U18.38 (VSS), U18.51 (VSS), U18.61 (VSS), U18.83 (VSS), U18.94 (VSS), U18.107 (VSS), U18.120 (VSS), U18.130 (VSS), U19.4 (GND), Y2.2 (G), Y2.4 (G), Y3.2 (G), Y3.4 (G)
GNDS: C89.1, J4.R8, J4.SH, R72.2
LAN8742A_VDDA: C83.1, C84.1, C85.1, C86.1, C87.1, C88.1, FB1.2, J4.R4 (TCT), J4.R5 (RCT), R65.1, R66.1, R67.1, R68.1, U9.1 (VDD2A), U9.19 (VDD1A), U12.5 (VBUS)
LAN8742A_VDDCR: C80.1, C81.1, C82.1, U9.6 (VDDCR)
LED_B: R40.1, U18.118 (PD4)
LED_G: R184.1, U18.129 (PG14)
LED_R: R185.1, U18.117 (PD3)
MCU_BOOT0: R130.1, U18.138 (BOOT0)
MCU_RESET: C132.1, D4.3 (K), J14.10 (~RESET), R131.2, SW1.1, U18.25 (NRST)
MCU_SWD_CLK: J14.4 (SWCLK/TCK), U18.109 (PA14)
MCU_SWD_DIO: J14.2 (SWDIO/TMS), U18.105 (PA13)
unnamed: C5.2, R5.2
unnamed: C8.1, C9.1, Q3.1 (S), Q3.2 (S), Q3.3 (S), U1.22 (BAT), U1.23 (BAT)
unnamed: C20.1, R15.2
unnamed: C1.1, D3.3 (K), R1.2, R2.1
unnamed: D5.1 (BK), R185.2
unnamed: D5.2 (GK), R184.2
unnamed: D5.3 (RK), R40.2
unnamed: J4.L2, R69.1
unnamed: J4.L3, R70.1
unnamed: Q1.3 (G), Q2.3 (G), R3.2, R4.1, R5.1
unnamed: C2.1, Q1.4 (S), Q2.4 (S), R3.1, U2.24 (VDD)
unnamed: C16.1, Q3.4 (G), U1.24 (SDRV)
unnamed: Q4.5 (D), Q5.5 (D)
unnamed: Q4.4 (G), R23.2, R24.1
unnamed: Q5.4 (G), R25.2, R26.1
unnamed: C7.1, R14.2, U1.18 (BATP)
unnamed: C18.1, U1.4 (BTST1)
unnamed: C17.2, U1.19 (BTST2)
unnamed: R9.1, R10.1, U1.17 (ILIM_HIZ)
unnamed: C24.1, C25.1, C26.1, C27.1, C28.1, C29.1, U1.29 (PMID)
unnamed: R11.1, U1.20 (PROG)
unnamed: C18.2, L1.1, U1.28 (SW1)
unnamed: C17.1, L1.2, U1.26 (SW2)
unnamed: R6.2, U2.9 (DISCH)
unnamed: R2.2, U2.18 (VBUS_VS_DISCH)
unnamed: C3.1, U2.21 (VREG_1V2)
unnamed: C30.1, U3.2 (AVDD), U3.20 (CCFG)
unnamed: R28.1, U3.16 (CBI)
unnamed: R25.1, U3.13 (CHG)
unnamed: R23.1, U3.12 (DSG)
unnamed: R27.1, U3.14 (LD)
unnamed: R29.1, U3.17 (OCDP)
unnamed: R31.2, U3.22 (PRES)
unnamed: C36.1, R21.2, U3.8 (VC0)
unnamed: C34.1, C35.2, R20.2, U3.7 (VC1)
unnamed: C33.1, C34.2, R19.2, U3.6 (VC2)
unnamed: C32.1, C33.2, R18.2, U3.5 (VC3)
unnamed: C32.2, R17.2, U3.3 (VC5), U3.4 (VC4)
unnamed: C31.2, R16.2, R31.1, U3.1 (VDD)
unnamed: R30.1, U3.19 (VTB)
unnamed: C43.1, C43.2, L3.1, U4.7 (BOOT), U4.8 (SW)
unnamed: R36.2, R37.1, U4.5 (FB)
unnamed: C50.1, U4.6 (VCC)
unnamed: C51.1, C51.2, L2.1, U5.7 (BOOT), U5.8 (SW)
unnamed: R34.2, R35.1, U5.5 (FB)
unnamed: C41.1, U5.6 (VCC)
unnamed: C62.1, C62.2, L4.1, U6.7 (BOOT), U6.8 (SW)
unnamed: R39.2, R42.1, U6.5 (FB)
unnamed: C61.1, U6.6 (VCC)
unnamed: R32.1, R33.1, U7.3 (FB)
unnamed: C39.1, U7.8 (NR/SS)
unnamed: R64.1, U9.24 (RBIAS)
unnamed: C77.1, U9.5 (XTAL1/CLKIN), Y3.1
unnamed: C78.1, U9.4 (XTAL2), Y3.3
unnamed: R45.2, U10.4 (SCK), U11.15 (S_SCL)
unnamed: R46.2, U10.3 (SDI), U11.16 (S_SDA)
unnamed: C74.1, U11.9 (CAP)
unnamed: C70.1, U11.27 (XIN32), Y1.1
unnamed: C71.1, U11.26 (XOUT32), Y1.2
unnamed: R89.1, R98.2, U15.2 (A0)
unnamed: R88.1, R97.2, U15.3 (A1)
unnamed: R87.1, R96.2, U15.4 (A2)
unnamed: R86.1, R95.2, U15.5 (A3)
unnamed: R85.1, R94.2, U15.6 (A4)
unnamed: R84.1, R93.2, U15.7 (A5)
unnamed: R83.1, R92.2, U15.8 (A6)
unnamed: R82.1, R91.2, U15.9 (A7)
unnamed: R90.2, U15.1 (A->B)
unnamed: R100.2, R101.1, U16.1 (-)
unnamed: R103.2, R104.1, U16.5 (-)
unnamed: R109.2, R110.1, U16.8 (-)
unnamed: R107.2, R108.1, U16.12 (-)
unnamed: R171.2, U18.70 (PB11)
unnamed: R172.2, U18.73 (PB12)
unnamed: R173.2, U18.74 (PB13)
unnamed: R161.1, U18.26 (PC0)
unnamed: R169.1, U18.28 (PC2_C)
unnamed: R170.1, U18.29 (PC3_C)
unnamed: C134.1, U18.8 (PC14-OSC32_IN), Y4.2
unnamed: C133.1, U18.9 (PC15-OSC32_OUT), Y4.1
unnamed: R162.1, U18.114 (PD0)
unnamed: R163.1, U18.115 (PD1)
unnamed: R164.1, U18.77 (PD8)
unnamed: R165.1, U18.78 (PD9)
unnamed: R166.1, U18.79 (PD10)
unnamed: R167.1, U18.85 (PD14)
unnamed: R168.1, U18.86 (PD15)
unnamed: R129.2, U18.143 (PDR_ON)
unnamed: R133.2, U18.141 (PE0)
unnamed: R132.2, U18.142 (PE1)
unnamed: R134.2, U18.58 (PE7)
unnamed: R135.2, U18.59 (PE8)
unnamed: R136.2, U18.60 (PE9)
unnamed: R137.2, U18.63 (PE10)
unnamed: R138.2, U18.64 (PE11)
unnamed: R139.2, U18.65 (PE12)
unnamed: R140.2, U18.66 (PE13)
unnamed: R141.2, U18.67 (PE14)
unnamed: R142.2, U18.68 (PE15)
unnamed: R143.2, U18.10 (PF0)
unnamed: R144.2, U18.11 (PF1)
unnamed: R145.2, U18.12 (PF2)
unnamed: R146.2, U18.13 (PF3)
unnamed: R147.2, U18.14 (PF4)
unnamed: R148.2, U18.15 (PF5)
unnamed: R149.2, U18.49 (PF11)
unnamed: R150.2, U18.50 (PF12)
unnamed: R151.2, U18.53 (PF13)
unnamed: R152.2, U18.54 (PF14)
unnamed: R153.2, U18.55 (PF15)
unnamed: R160.1, U18.56 (PG0)
unnamed: R159.1, U18.57 (PG1)
unnamed: R158.1, U18.87 (PG2)
unnamed: R157.1, U18.89 (PG4)
unnamed: R156.1, U18.90 (PG5)
unnamed: R155.1, U18.93 (PG8)
unnamed: R154.1, U18.132 (PG15)
unnamed: C131.1, U18.23 (PH0-OSC_IN), Y2.3
unnamed: C130.1, U18.24 (PH1-OSC_OUT), Y2.1
unnamed: C108.1, U18.71 (VCAP1)
unnamed: C107.1, U18.106 (VCAP2)
unnamed: R177.2, U19.5 (EN)
POWER_I2C_SCL: R175.2, U18.81 (PD12), U19.2 (SCLA)
POWER_I2C_SDA: R176.2, U18.82 (PD13), U19.3 (SDAA)
REGN: C6.1, R9.2, R13.1, U1.5 (REGN)
SDCARD.CLK: U8.4 (CH4), U18.113 (PC12)
SDCARD.CMD: R78.2, U8.3 (CH3), U18.116 (PD2)
SDCARD.D0: R79.2, U8.5 (CH5), U18.98 (PC8)
SDCARD.D1: R80.2, U8.6 (CH6), U18.99 (PC9)
SDCARD.D2: R81.2, U8.1 (CH1), U18.111 (PC10)
SDCARD.D3: R77.2, U8.2 (CH2), U18.112 (PC11)
SDCARD._CLK: J5.5 (CLK), U8.9 (CH4)
SDCARD._CMD: J5.3 (CMD), U8.10 (CH3)
SDCARD._DAT0: J5.7 (DAT0), U8.8 (CH5)
SDCARD._DAT1: J5.8 (DAT1), U8.7 (CH6)
SDCARD._DAT2: J5.1 (DAT2), U8.12 (CH1)
SDCARD._DAT3: J5.2 (DAT3/CD), U8.11 (CH2)
SDRAM.IS42S16160J_A0: R143.1, U13.23 (A0)
SDRAM.IS42S16160J_A1: R144.1, U13.24 (A1)
SDRAM.IS42S16160J_A2: R145.1, U13.25 (A2)
SDRAM.IS42S16160J_A3: R146.1, U13.26 (A3)
SDRAM.IS42S16160J_A4: R147.1, U13.29 (A4)
SDRAM.IS42S16160J_A5: R148.1, U13.30 (A5)
SDRAM.IS42S16160J_A6: R150.1, U13.31 (A6)
SDRAM.IS42S16160J_A7: R151.1, U13.32 (A7)
SDRAM.IS42S16160J_A8: R152.1, U13.33 (A8)
SDRAM.IS42S16160J_A9: R153.1, U13.34 (A9)
SDRAM.IS42S16160J_A10: R160.2, U13.22 (A10)
SDRAM.IS42S16160J_A11: R159.2, U13.35 (A11)
SDRAM.IS42S16160J_A12: R158.2, U13.36 (A12)
SDRAM.IS42S16160J_BA0: R157.2, U13.20 (BA0)
SDRAM.IS42S16160J_BA1: R156.2, U13.21 (BA1)
SDRAM.IS42S16160J_CAS: R154.2, U13.17 (~CAS)
SDRAM.IS42S16160J_CKE: R74.2, R170.2, U13.37 (CKE)
SDRAM.IS42S16160J_CLK: R155.2, U13.38 (CLK)
SDRAM.IS42S16160J_CS: R73.2, R169.2, U13.19 (~CS)
SDRAM.IS42S16160J_DQ0: R167.2, U13.2 (DQ0)
SDRAM.IS42S16160J_DQ1: R168.2, U13.4 (DQ1)
SDRAM.IS42S16160J_DQ2: R162.2, U13.5 (DQ2)
SDRAM.IS42S16160J_DQ3: R163.2, U13.7 (DQ3)
SDRAM.IS42S16160J_DQ4: R134.1, U13.8 (DQ4)
SDRAM.IS42S16160J_DQ5: R135.1, U13.10 (DQ5)
SDRAM.IS42S16160J_DQ6: R136.1, U13.11 (DQ6)
SDRAM.IS42S16160J_DQ7: R137.1, U13.13 (DQ7)
SDRAM.IS42S16160J_DQ8: R138.1, U13.42 (DQ8)
SDRAM.IS42S16160J_DQ9: R139.1, U13.44 (DQ9)
SDRAM.IS42S16160J_DQ10: R140.1, U13.45 (DQ10)
SDRAM.IS42S16160J_DQ11: R141.1, U13.47 (DQ11)
SDRAM.IS42S16160J_DQ12: R142.1, U13.48 (DQ12)
SDRAM.IS42S16160J_DQ13: R164.2, U13.50 (DQ13)
SDRAM.IS42S16160J_DQ14: R165.2, U13.51 (DQ14)
SDRAM.IS42S16160J_DQ15: R166.2, U13.53 (DQ15)
SDRAM.IS42S16160J_DQMH: R132.1, U13.39 (DQMH)
SDRAM.IS42S16160J_DQML: R133.1, U13.15 (DQML)
SDRAM.IS42S16160J_RAS: R149.1, U13.18 (~RAS)
SDRAM.IS42S16160J_WE: R75.2, R161.2, U13.16 (~WE)
STUSB4500_INT: R180.2, U2.19 (ALERT), U18.97 (PC7)
STUSB4500_RST: R38.1, U2.6 (RESET), U18.119 (PD5)
SYSTEM_LOAD: C10.1, C11.1, C12.1, C13.1, C14.1, C15.1, C40.1, C42.1, C48.1, C49.1, C57.1, C58.1, U1.25 (SYS), U4.2 (VIN), U4.3 (EN), U5.2 (VIN), U5.3 (EN), U6.2 (VIN), U6.3 (EN)
USART_RX: J3.1, U18.76 (PB15)
USART_TX: J3.2, U18.75 (PB14)
USB_CC1: D1.1 (K), J1.A5 (CC1), U2.1 (CC1DB), U2.2 (CC1)
USB_CC2: D1.2 (K), J1.B5 (CC2), U2.4 (CC2), U2.5 (CC2DB)
USB_DM: J1.A7 (D-), J1.B7 (D-), U1.7 (D-)
USB_DP: J1.A6 (D+), J1.B6 (D+), U1.6 (D+)
USB_VBUS: D3.1 (A), J1.A4 (VBUS), J1.A9 (VBUS), J1.B4 (VBUS), J1.B9 (VBUS), Q1.1 (D), Q1.2 (D), Q1.5 (D), Q1.6 (D), R1.1
VBUS_EN_SNK: R4.2, U2.16 (VBUS_EN_SNK)
VDDA: C126.1, C128.1, C129.1, FB2.2, U18.32 (VREF+), U18.33 (VDDA)
VL53LOx_INT_1: J10.1, R128.2, U18.46 (PB0)
VL53LOx_INT_2: J11.1, R127.2, U18.47 (PB1)
VL53LOx_INT_3: J12.1, R126.2, U18.1 (PE2)
VL53LOx_INT_4: J13.1, R125.2, U18.2 (PE3)
VL53LOx_SCL_1: J10.4, R113.2, U17.3 (SCL1)
VL53LOx_SCL_2: J11.4, R119.2, U17.6 (SCL2)
VL53LOx_SCL_3: J12.4, R121.2, U17.10 (SCL3)
VL53LOx_SCL_4: J13.4, R123.2, U17.13 (SCL4)
VL53LOx_SCL_TO_MCU: R112.2, U17.1 (SCL0), U18.136 (PB6)
VL53LOx_SDA_1: J10.3, R114.2, U17.4 (SDA1)
VL53LOx_SDA_2: J11.3, R120.2, U17.7 (SDA2)
VL53LOx_SDA_3: J12.3, R122.2, U17.11 (SDA3)
VL53LOx_SDA_4: J13.3, R124.2, U17.14 (SDA4)
VL53LOx_SDA_TO_MCU: R111.2, U17.2 (SDA0), U18.137 (PB7)
VL53LOx_XSHUT_1: J10.2, R115.1, U17.5 (EN1), U18.125 (PG10)
VL53LOx_XSHUT_2: J11.2, R116.1, U17.9 (EN2), U18.126 (PG11)
VL53LOx_XSHUT_3: J12.2, R117.1, U17.12 (EN3), U18.127 (PG12)
VL53LOx_XSHUT_4: J13.2, R118.1, U17.15 (EN4), U18.128 (PG13)
