Fogotcheck/TracTorKi/(commit log)

2026-03-03 feat: add charger
    [TracTorKi.kicad_pcb, TracTorKi.kicad_sch, power.kicad_sch]
2026-03-03 feat: add gitignore
    [balance.kicad_sch, power.kicad_sch]
2026-03-05 fix: rm TXS0108EPW №1
    - change ACCB -> 5В LM
    [Level_Shifter.kicad_sch]
2026-03-06 fix: charger schem
    [BQ25798.kicad_sch, BQ77915.kicad_sch, Level_Shifter.kicad_sch, power.kicad_sch, power_out.kicad_sch]
2026-03-06 fix: charger
    -rm status OK2,OK3,attach;
    [power.kicad_sch]
2026-03-06 feat: STUSB4500 - add print
    [power.kicad_sch]
2026-03-06 feat: BQ25798, BQ77915 add print
    [BQ25798.kicad_sch, BQ77915.kicad_sch]
2026-03-06 fix: charger
    - BQ77915 RSNS 1M ->1 mΩ
    [BQ77915.kicad_sch, Level_Shifter.kicad_sch, power_out.kicad_sch]
2026-03-06 fix: BQ77915 charger
    - srnp,snrn - diff pair
    [BQ77915.kicad_sch, TracTorKi.kicad_pcb]
2026-03-06 fix: charger style
    [power_out.kicad_sch]
2026-03-07 feat: add bno085
    [TracTorKi.kicad_pcb, TracTorKi.kicad_sch, imu.kicad_sch]
2026-03-10 fix: refactor, optimize gitignore and remove cache
    [BQ76942.kicad_sch, balance.kicad_sch]
2026-03-10 fix: refactor move *.kicad_sch -> ./sch
    [BQ25798.kicad_sch, BQ77915.kicad_sch, Level_Shifter.kicad_sch, TracTorKi.kicad_pcb, TracTorKi.kicad_sch, imu.kicad_sch, power.kicad_sch, power_out.kicad_sch]
2026-03-10 fix: refactor move schem
    [BQ25798.kicad_sch, BQ77915.kicad_sch, Level_Shifter.kicad_sch, TracTorKi.kicad_pcb, TracTorKi.kicad_sch, imu.kicad_sch, power.kicad_sch, power_out.kicad_sch]
2026-03-10 feat: add ethernet
    [BQ77915.kicad_sch, Ethernet.kicad_sch, TracTorKi.kicad_pcb, TracTorKi.kicad_sch]
2026-03-10 fix: ethernet
    Y3 add gnd
    [Ethernet.kicad_sch]
2026-03-11 feat: add SDRAM IS42S16160J-7TLI-TR
    [Memory.kicad_sch, TracTorKi.kicad_pcb, TracTorKi.kicad_sch]
2026-03-11 feat: add sd card
    [Memory.kicad_sch, SDCard.kicad_sch, TracTorKi.kicad_pcb]
2026-03-12 feat: add BTS7960
    [Motor.kicad_sch, TracTorKi.kicad_pcb, TracTorKi.kicad_sch]
2026-03-12 feat: add VL53LOx
    [TracTorKi.kicad_pcb, TracTorKi.kicad_sch, VL53LOx.kicad_sch]
2026-03-12 feat: add stm32h743zit6
    [TracTorKi.kicad_pcb, TracTorKi.kicad_sch, stm23H743zit6.kicad_sch, stm23H743zit6_1.kicad_sch, stm23H743zit6_2.kicad_sch]
2026-03-12 fix: move stm32h743zit6.kicad_sym
2026-03-13 feat: mcu add clock
    - add swd
    [TracTorKi.kicad_pcb, stm23H743zit6.kicad_sch, stm23H743zit6_1.kicad_sch]
2026-03-13 feat: memory connect to mcu
    [Memory.kicad_sch, SDCard.kicad_sch, TracTorKi.kicad_pcb, stm23H743zit6.kicad_sch, stm23H743zit6_1.kicad_sch]
2026-03-13 feat; eth connect to mcu
    [Ethernet.kicad_sch, TracTorKi.kicad_pcb, stm23H743zit6.kicad_sch]
2026-03-13 feat: NC changes
    [TracTorKi.kicad_pcb]
2026-03-13 fix: change gird
    [TracTorKi.kicad_pcb]
2026-03-13 fix: NC changes
    [stm23H743zit6_1.kicad_sch]
2026-03-16 fix: change charger level-shift
    TX0108EPW -> TCA9517ADGK
    [Level_Shifter.kicad_sch, TracTorKi.kicad_pcb]
2026-03-16 fix: change charger connectors
    [BQ77915.kicad_sch, TracTorKi.kicad_pcb]
2026-03-16 feat: charger add connect to mcu
    [TracTorKi.kicad_pcb, stm23H743zit6.kicad_sch, stm23H743zit6_1.kicad_sch]
2026-03-16 feat: imu add connect to mcu
    [TracTorKi.kicad_pcb, stm23H743zit6.kicad_sch, stm23H743zit6_1.kicad_sch]
2026-03-16 feat: motor add connect to mcu
    [Motor.kicad_sch, TracTorKi.kicad_pcb, stm23H743zit6.kicad_sch, stm23H743zit6_1.kicad_sch]
2026-03-16 feat: tof add connect to mcu
    [TracTorKi.kicad_pcb, stm23H743zit6.kicad_sch, stm23H743zit6_1.kicad_sch]
2026-03-16 feat: add leds
    [LED.kicad_sch, TracTorKi.kicad_pcb, TracTorKi.kicad_sch, stm23H743zit6.kicad_sch, stm23H743zit6_1.kicad_sch]
2026-03-16 fix: swd swap pin
    [TracTorKi.kicad_pcb, stm23H743zit6.kicad_sch, stm23H743zit6_1.kicad_sch]
2026-03-16 feat: add usart debug
    [TracTorKi.kicad_pcb, stm23H743zit6.kicad_sch]
2026-03-18 feat: trace IS42S16160J-7TLI
    [TracTorKi.kicad_pcb, stm23H743zit6_2.kicad_sch]
2026-03-19 fix: rm trace IS42S16160J
    - add SDRAM_NET
    [TracTorKi.kicad_pcb]
2026-03-19 fix: trace IS42S16160J
    [TracTorKi.kicad_pcb]
2026-03-20 feat: add sdcard trace
    - change rule 3.3V
    [BQ25798.kicad_sch, BQ77915.kicad_sch, Ethernet.kicad_sch, LED.kicad_sch, Level_Shifter.kicad_sch, Memory.kicad_sch, Motor.kicad_sch, SDCard.kicad_sch]
2026-03-20 fix: resize edge.cuts
    - 100X200
    [TracTorKi.kicad_pcb]
2026-03-20 fix: ethernet align
    [TracTorKi.kicad_pcb]
2026-03-20 fix: rm gnds conn
    [TracTorKi.kicad_pcb]
2026-03-20 feat: add status trace
    [TracTorKi.kicad_pcb]
2026-03-21 feat: trace charger
    [BQ77915.kicad_sch, TracTorKi.kicad_pcb]
2026-03-24 fix: move elements
    - retrace ethernet;
    - retrace sdcard;
    [Ethernet.kicad_sch, TracTorKi.kicad_pcb]
2026-03-24 feat: trace motor
    [TracTorKi.kicad_pcb]
2026-03-24 feat: trace tof
    [TracTorKi.kicad_pcb]
2026-03-24 feat: trace imu
    [TracTorKi.kicad_pcb]
2026-03-25 fix: fill, 3.3, gnd
    [BQ77915.kicad_sch, TracTorKi.kicad_pcb, stm23H743zit6.kicad_sch]
2026-03-26 feat: kicad version 9.x.x -> 10.0.0
    [BQ25798.kicad_sch, BQ77915.kicad_sch, Ethernet.kicad_sch, LED.kicad_sch, Level_Shifter.kicad_sch, Memory.kicad_sch, Motor.kicad_sch, SDCard.kicad_sch]
2026-03-26 fix: pcb style
    [TracTorKi.kicad_pcb]
2026-03-26 fix: rm via vcap
    [TracTorKi.kicad_pcb]
2026-09-13 feat: update version cad;
    [BQ25798.kicad_sch, BQ77915.kicad_sch, Ethernet.kicad_sch, LED.kicad_sch, Level_Shifter.kicad_sch, Memory.kicad_sch, Motor.kicad_sch, SDCard.kicad_sch]
2026-11-03 fix: update kicad version
    [TracTorKi.kicad_pcb, power.kicad_sch]
2026-11-03 fix: add DRC report to repository
    [BQ77915.kicad_sch, Ethernet.kicad_sch, TracTorKi.kicad_pcb, power.kicad_sch, power_out.kicad_sch, stm23H743zit6.kicad_sch, stm23H743zit6_1.kicad_sch, stm23H743zit6_2.kicad_sch]
2026-11-09 bug: Need rewrite;
    [TracTorKi.kicad_pcb]
2026-11-09 fix: pcb ethernet diff pairs impedance and skew
    [TracTorKi.kicad_pcb]
2026-11-09 fix: ethernet add comment
    [BQ77915.kicad_sch, Ethernet.kicad_sch, power.kicad_sch, power_out.kicad_sch, stm23H743zit6_2.kicad_sch]
2026-11-09 fix: ethernet skew line
    TXD0, TXD1, TXEN
    RXD0, RXD1, CRS_DV, RXER
    [TracTorKi.kicad_pcb]
2026-11-10 fix: SDCard EMIF06 -> IP4252CZ12
    [SDCard.kicad_sch, TracTorKi.kicad_pcb]
2026-11-10 fix: DRC
    [TracTorKi.kicad_pcb]
2026-11-10 fix: SDCard add via
    [TracTorKi.kicad_pcb]
2026-11-11 fix: kicad_pcb
    - ethernet - fix TD 0.127 -> 0.152;
    - c56 - change footprint;
    - sw - change footprint;
    - D1,D4 - change footprint;
    [Ethernet.kicad_sch, Motor.kicad_sch, TracTorKi.kicad_pcb, power.kicad_sch, power_out.kicad_sch, stm23H743zit6_1.kicad_sch, stm23H743zit6_2.kicad_sch]
2026-11-11 fix: pcb
    [TracTorKi.kicad_pcb]
2026-11-12 fix: warnings 110 -> 79
    [TracTorKi.kicad_pcb]
2026-11-12 fix: usb_DP, usb_DN - same Lines
    warnings 79 -> 76
    [TracTorKi.kicad_pcb]
2026-11-12 feat: add production files
    [TracTorKi-B_Cu.gbr, TracTorKi-B_Mask.gbr, TracTorKi-B_Paste.gbr, TracTorKi-B_Silkscreen.gbr, TracTorKi-Edge_Cuts.gbr, TracTorKi-F_Cu.gbr, TracTorKi-F_Mask.gbr, TracTorKi-F_Paste.gbr]
