Fogotcheck/TracTorKi/(notices)

Notices in the files:
parts and their libraries:
Copyright: Copyright (C) 2025 Ultra Librarian. All rights reserved.
